RunningJoke/reactionButton/docs/firmware/architecture.md

# Firmware architecture

## 1. Hardware and quick facts

| Item | Value |
|---|---|
| MCU | ESP32-C3 (single-core RISC-V, 160 MHz), board `esp32-c3-devkitm-1`, 4 MB flash |
| Framework | PlatformIO, `framework = arduino, espidf` (Arduino as ESP-IDF component) |
| Button | GPIO 3, active LOW (external pull-up, `pinMode INPUT`); RTC pin, wakes from deep sleep |
| LEDs | 18 × WS2812 (GRB, 800 kHz) on GPIO 7 |
| Battery | GPIO 5, ADC2 (`analogReadMilliVolts`) through a 1:1 divider (2 × 100 k) |
| Random seed | GPIO 0 ADC read once |
| Pod link | ESP-NOW, WiFi channel 1, ≤ 7 peripherals (`CentralRole::MAX_PERIPHERALS`); shipped programs use ≤ 4 |
| Phone | BLE (NimBLE-Arduino 1.4.3 host on the IDF controller, ADR 0008), peripheral role, one phone, MTU 517; central only |
| Libraries | Adafruit NeoPixel ^1.12.0, ArduinoJson ^7.4.2, NimBLE-Arduino 1.4.3 |

Sources: `hardware/pcb` (KiCad), `hardware/casing` (FreeCAD).

## 2. Build configuration

| File | Purpose |
|---|---|
| `platformio.ini` | single env `NewBoard`, USB-CDC console |
| `sdkconfig.NewBoard` | WiFi + SW coexistence, BT controller only (`BT_CONTROLLER_ONLY`; the host stack is NimBLE-Arduino), `FREERTOS_HZ=1000`, task WDT off, C++ exceptions off, `-Os`, log level INFO (`CONFIG_LOG_MAXIMUM_LEVEL=3`), assertions on, `CONFIG_ADC_ONESHOT_FORCE_USE_ADC2_ON_C3`. Controller limits are changed here (`pio run -d firmware -t menuconfig`); NimBLE host limits are `-DCONFIG_BT_NIMBLE_*` build flags in `platformio.ini` |
| `partitions.csv` | nvs 20 KB, otadata, **two** app slots `ota_0` / `ota_1` 1 792 KB each, SPIFFS 384 KB, coredump 64 KB (ADR 0009) |
| `CMakeLists.txt`, `src/CMakeLists.txt` | ESP-IDF glue (globs `src/`) |

**Serial port:** with `arduino, espidf` the core is built without `ARDUINO_USB_CDC_ON_BOOT`, so `Serial` is
UART0 (GPIO 20/21). The firmware uses its own USB console (`Config/Console`), which also gets the ESP-IDF
log. Do not add `ARDUINO_USB_CDC_ON_BOOT`/`ARDUINO_USB_MODE` to `platformio.ini` (they only reach `src/`,
`Serial` would mean two objects). Panic dumps still go to UART0; the `boot` event (reset reason + last
step) replaces them.

## 3. Modules (`src/`)

```
main.cpp            setup(): battery gauge, role; loop(): battery, role
_Definitions.h      FW_VERSION_*, pins, ESP-NOW channel, BLE UUIDs, LED_BRIGHTNESS_CAP, AUTO_POWER_OFF_MINUTES
Roles/              RoleManager (role at boot), IRole (run, idle, powerOffAllowed)
  Central/          CentralRole (menu, discovery, confirm, run, pause), PodNetwork (claims, heartbeats,
                    ARM/RESET/EFFECT, events; implements Link/IPodNetwork), PhoneConfig (BLE config API)
  Peripheral/       PeripheralRole (announce, claim, clock sync, arm/measure/report, identity)
Link/               Protocol.h (wire format), EspNowLink (reliable ordered unicast, dedupe, tx timestamps,
                    idleWait), ClockSync.h, IPodNetwork.h, HoldSession (hold measuring + animation)
Config/             ConfigApi (JSON requests, shared by BLE and USB), SerialConsole, Console
Diagnostics/Diag    reset reason + last step across reboots
Settings/           NVS: set id, store generation, boot role, set name, PIN
Power/AutoPowerOff  idle timer, goodbye animation, deep sleep (§8)
Battery/            cell voltage, percent, low-battery thresholds
Store/              ProgramStore (files, CRC, manifest, atomic commit, generation), StoreSync (pod-to-pod)
BlockManager/       loads programs, runs the block graph (§6)
Block/              Block base (configure / enter / execute / exit / resume, named ports), BlockContext,
                    Value (constant or variable), JsonUtil, BlockFactory (type → class), EffectTarget,
                    Countdown, RandomUtil, one folder per block type
Program/ProgramCatalog  menu from /programs.json
Input/Button        debounced, edge counters, µs timestamps
Results/            Results (records, statistics, RESULT/SUMMARY lines), Reports (log + report buffer)
VariableManager/    int64 variables, names resolved to ids at load
LEDManager/         NeoPixel wrapper, effect player, SystemPattern (§7.1), Identity.h, EffectJson
ColorSet/           RGB + colour constants
```

Managers are lazily created singletons (`getManager()`), allocated once, never freed. Blocks use
`BlockContext`, not the singletons.

## 4. Boot

Power on → Serial, SPIFFS, pins → BOOT pattern 2.6 s (§7.1: battery gauge 1 s, then white fills the ring in
1.6 s) → button held at the end?
yes: `CentralRole` (BLE `ReactPod xxxx`), no: `PeripheralRole` (ESP-NOW, HELLO). The role changes only by
reboot. Wake from deep sleep is a normal boot.

### 4.1 First start after a firmware update (#124, ADR 0009)

`CONFIG_APP_ROLLBACK_ENABLE` is on, and `Ota.cpp` overrides the framework's weak `verifyRollbackLater()`, so
`initArduino()` does **not** mark the new image valid (its default does so unconditionally). The image stays
`ESP_OTA_IMG_PENDING_VERIFY`, and `Ota::service()` decides once, 15 s after start (`SELF_TEST_MS`):

- **Self-test passes:** `esp_ota_mark_app_valid_cancel_rollback`, `info.ota.lastResult` = `ok`. The test is
  deliberately small, so that no ordinary situation fails it: SPIFFS mounted, the role object exists, and the
  radio of the role is up: BLE (NimBLE initialised) on a central, ESP-NOW on a peripheral. The central's
  ESP-NOW radio is off in the menu (#122), so it is not tested there. Not tested: a phone, peripherals,
  programs, battery.
- **Self-test fails:** `esp_ota_mark_app_invalid_rollback_and_reboot` returns to the old slot at once. If there is
  no valid other slot (the call returns an error), the image is kept and marked valid: a pod never
  boot-loops. A pod flashed over USB is never on trial (the upload resets `otadata`, state undefined), so
  this does not apply to it.
- **Panic, watchdog or any reset inside the 15 s** (also a power cut): the bootloader sees `PENDING_VERIFY`
  at the next reset, marks the image aborted and starts the old one. A pod switched off in the first 15 s
  after an update therefore comes back with the old firmware; this is the design (the image has not
  proved itself yet), the update has to be repeated.
- **Role after a rollback.** `otaActivate` stores the pod's role in the high nibble of the pending-slot entry. The failed
  boot uses up the one-shot boot role, so after a rollback `Ota::boot` sets it again: a central that rolled back comes
  back as a central, not as a peripheral. An entry written by firmware 2.19 has no role (a rollback to or from it keeps the
  old behaviour).
- `otaBegin` is refused with `busy` during the 15 s (ESP-IDF cannot start a new image while the running one
  is pending).
- `lastResult` (`Ota::boot`): `otaActivate` stores the new slot in NVS. At the next start the pod compares
  it with the running slot: equal and valid: `ok`; equal and still pending: wait for the verdict; different:
  the bootloader rolled back, `rolledBack` if `esp_ota_get_last_invalid_partition` is that slot. The entry
  is cleared on that boot, the result stays until the next `otaBegin`. This NVS comparison is kept (instead of
  asking only `esp_ota_get_last_invalid_partition`) because it also knows `ok` and can be reset by `otaBegin`,
  while the invalid mark stays in `otadata` until the slot is written again.

### 4.2 Signed images (#134, ADR 0009)

`CONFIG_SECURE_SIGNED_APPS_NO_SECURE_BOOT` + `CONFIG_SECURE_SIGNED_APPS_RSA_SCHEME` +
`CONFIG_SECURE_SIGNED_ON_UPDATE_NO_SECURE_BOOT` (`sdkconfig.NewBoard`): `esp_ota_end` (and `esp_ota_set_boot_partition`)
verify an RSA-3072 signature block (secure boot v2 format, appended after the image, 4 KB aligned) in the app, **without**
secure boot: no eFuse is read or burned, `CONFIG_SECURE_BOOT` and flash encryption stay off, the bootloader does not
check signatures, USB flashing of any image still works. The trusted key is the one the **running** image was signed with
(`esp_secure_boot_get_signature_blocks_for_running_app`, nothing is embedded in the source): an update is accepted only
if it carries a valid block of the same public key. So a pod must itself run a signed image, and a pod flashed with a
developer build (test key) accepts only developer images. `firmware/sign_ota.py` (PlatformIO `post:` script) signs
`firmware.bin` after every build with `espsecure.py sign_data --version 2` and checks the result. Cost: `firmware.bin`
+13 KB (code 9 KB, signature sector 4 KB). Setup, release key and tests: testing §14, skill `/release`.

## 5. State machines

### 5.1 Peripheral

| State | Enter / behaviour |
|---|---|
| UNCLAIMED | SEARCH: amber spot bouncing over LEDs 8–17 (fw ≥ 2.15; 2.13–2.14: yellow + MAC-derived 2-LED segment); HELLO every 250 ms; hold the button 3 s → set id cleared (white flash 0.5 s) |
| READY | CLAIM from a central of its set (or any, if unpaired); PING every 200 ms; JOINED while the central sets the identify flag: n LEDs (pod n) flash twice, then 30 %; LEDs 8–17 breathe green. A re-claim flashes again (fw ≥ 2.15; 2.13–2.14: number, then spin; link-protocol §2.4) |
| READY, battery < 15 % | LOW_BATTERY replaces JOINED: LED 9 amber, 200 ms on per second (§7.1) |
| SCHEDULED | ARM with a start time; → ACTIVE when the synced clock reaches it |
| ACTIVE | LEDs updated, then `t0` taken; only presses that start after count; reaction = press edge − `t0` (µs) |
| DONE | press reported (PRESSED); → READY on RESET |
| HOLDING | CHARGE / RELEASE activation running (`HoldSession`) |
| UPDATE | firmware update from the central (fw ≥ 2.20, link-protocol §5.3): entered with `OTA_OFFER` from READY. The slot is erased (about 4 s, PING `otaState` preparing first, supervision restarted afterwards), then the image is pulled (`@ota`) or heard (`OTA_CHUNK`), chunks in any order (`OtaBitmap`), written with `esp_ota_write_with_offset`, hashed from the flash, `esp_ota_end`, READY ring green. PING/PONG go on, ARM / EFFECT / RESET are ignored. Left by `OTA_ACTIVATE` (restart as peripheral), by a PONG without `PONG_FLAG_OTA` (discard, READY), or by losing the central (UNCLAIMED). A failed update stays `failed` (red blink, then dark) until the central ends the distribution |

RESET from any armed state → READY. No PONG for 2 s → UNCLAIMED. Frames are handled on arrival, in send
order. An EFFECT takes the ring until it ends; ARM or RESET gives the ring back to the activation.

### 5.2 Central

| State | Enter / behaviour |
|---|---|
| MENU | menu from `/programs.json`, the program's own pattern shown at once (static); the boot hold is ignored until released; short press (< 1 s) = next program; hold: after 200 ms SELECT (white fills clockwise, full at 1.8 s = load it), released earlier: SELECT_CANCEL (§7.1); MaxLoop override read now, then the characteristic is reset to `-1` (it applies to this select only) |
| SELECTED | the ring flashes white twice (0.7 s), then DISCOVERY |
| ERROR | no programs or load error: red blink (1 s on/off), reboot needed. Programs can still be uploaded |
| DISCOVERY | non-blocking, one claim per HELLO; LEDs 0–7 pod markers in the pod colour, SEARCH on 8–17 (§7.1); SOLO (0 peripherals) never starts ESP-NOW |
| CONFIRM | all required pods claimed: READY (whole ring breathes green); a press that starts after entering starts the game; earlier events dropped. `setVariables` is accepted here (`startVars`, config-api §3): the values are used by the first cycle. Start refused below 5 % battery: red 1 s |
| RUN | the game. `stop` (config API) leaves any state after MENU for MENU without a reboot: block, variables, results and reports are dropped, the ring shows the menu, BLE stays connected, the radio keeps running and the joined pods get RESET and stay joined (UNCLAIMED only if the central is silent > 2 s). The next `select` keeps the first `peripherals` of them and goes through DISCOVERY |
| DISTRIBUTING | `otaDistribute` from MENU (fw ≥ 2.20, link-protocol §5.3): ESP-NOW on, pods claimed as in DISCOVERY, no game, no store sync, `PONG_FLAG_OTA` set. `PodNetwork::otaService` offers the image (one pod at a time, or all pods and a broadcast pass), ring: UPDATE bar with the mean progress, UPDATE_READY when every pod is ready. Left by `otaAbort` / `stop` (MENU) or `otaActivate` (OTA_ACTIVATE to the ready pods, then the central restarts as central) |
| PAUSED | PAUSED pattern (whole ring breathes amber) for a pod silent > 1.5 s or phone `pause` (`phonePaused`). Pod loss resumes by itself when all are back; a phone pause only with `resume` (config-api §5). The current block is left and re-entered (re-arms its pods) |

BLE (fw ≥ 2.12, `liveBle`, ADR 0005) stays connected in every state; `PhoneConfig::service()` runs in
`CentralRole::run()`, responses go out from a sender task (link-protocol §6). Lights with a start time
(`syncStartMs`) are armed on an esp_timer by `LEDManager::playEffect` (timing §4.1).

## 6. Block engine

### 6.1 Loading (`BlockManager::loadProgram`)

1. Clear blocks and variables. 2. Read the file; load `include`s first (recursive, depth ≤ 3), then its
`peripherals`, `variables`, `blocks`. 3. Per block `BlockFactory::create(type)` → `configure(json)`
(variable names → `VarId`). 4. Resolve port targets to indices. Unknown names, duplicates, unknown types
and bad parameters abort with a message naming file and block → error blink.

### 6.2 Execution (`BlockManager::run`, once per `loop()`, after `button.update()` and `network.service()`)

```
repeat up to 32 times:
    status = current.execute(ctx);  if running: return
    next = target[status.port];  if unconnected and block has "next": next = target[next]
    current.exit(); timerStop
    if no next: program ends
    current = next; timerStart; current.enter()
```

Semantics in detail: programs.md §7.

| JSON `type` | Class | Ports |
|---|---|---|
| `led` | `LEDBlock` | next |
| `delay` | `DelayBlock` | next |
| `button` | `ButtonBlock` | next, short, long, pressed, timeout |
| `if` | `IfBlock` | true, false |
| `setVariable` | `SetVariableBlock` | next |
| `remotePress` | `RemotePressBlock` | next, timeout |
| `remoteMultiPress` | `RemoteMultiplePressBlock` | next, avoidHit, timeout |
| `remoteResetAll` | `RemoteResetAllBlock` | next |
| `summary` | `SummaryBlock` | next |
| `repeat` | `RepeatBlock` | next, body, done |
| `effect` | `EffectBlock` | next |
| `charge` | `ChargeBlock` (on `HoldBlock`) | next, released, early, full, timeout |
| `release` | `ReleaseBlock` (on `HoldBlock`) | next, noHold, falseStart, timeout |
| `toggle` | `ToggleBlock` | next, allA, allB |
| `communicate` | `CommunicateBlock` | next, pressed, timeout, repeat, stop |

### 6.3 New block type

1. `src/Block/MyBlock/MyBlock.{h,cpp}` deriving from `Block`: `configure(json, ctx)` (use `Value`,
   `JsonUtil`; `ctx.fail("…")` on bad input), `enter(ctx)` (reset, take times), `execute(ctx)`
   (`BlockStatus::running()` / `done(port)`), `portCount()`/`portName(i)`, `onProgramStart()` for state
   across entries, `resume()` if a pause must not re-run `enter()`.
2. One line in `BlockFactory.cpp`. 3. Then the `/fw-api-change` skill (validator, program model, app).

### 6.4 System variables

| Variable | Set from | Used by |
|---|---|---|
| `REQUIRED_PERIPHERALS` | `peripherals` | CentralRole (pods to claim), programs; also the central's pod id |
| `NODE_COUNT` | `peripherals + 1` | programs |
| `MAX_LOOPS` | program variables; MaxLoop characteristic overrides it at selection | `lib/loop.json` |

Unknown variables read 0.

### 6.5 Events and measurements

- ESP-NOW receive callbacks (WiFi task) only queue frames; `PodNetwork::service()` turns them into
  `PodEvent`s in the loop: PRESSED `{podId, cmdSeq, result, reactionUs, rxTimeUs}` (+ `owner`, `flipCount`
  for TOGGLE), RELEASED `{flags, heldMs, chargeMs}`.
- `IPodNetwork::arm()` returns the `cmdSeq`; a remote block accepts only events with its pod and `cmdSeq`.
- `record` / `timerStop` → `Results`: `RESULT,…` line, per-metric statistics for `summary`, and the
  measurement log (48 values) that `communicate` turns into reports (8 in RAM until `ack`).

## 7. LEDs (`LEDManager`)

- Colour index on the wire: `0 red, 1 green, 2 blue, 3 yellow, 4 magenta, 5 cyan, 6 white, 7 orange, 8 violet,
  10 cream, 255 off`; 7, 8 and 10 are identity colours, pods only (10 from fw 2.15). 9 amber is local only
  (battery warning, system patterns), never sent by a central. Other values ignored.
- Static calls: `setLEDColors(ColorSet*)`, `(colorId)`, `(index, ColorSet*)`, `(LEDPattern*)` (≤ 8 palette
  colours, 3 bits × 18 in a `uint64_t`, optional animation), `setSegment(first, count, colorId, restId)`.
  Every static call stops a running effect.
- `playEffect(EffectDesc, startUs, ledMask)` (fw ≥ 2.8): one effect at a time, frames = f(time since
  start) (link-protocol §2.1), shown only when changed, ≤ every 16 ms; first frame inside `playEffect`
  or from an esp_timer at a future start. `service()` runs after the role every pass and returns at once
  when nothing animates.
- Every driver write goes through `present()`: `show()` only if the buffer differs (fw ≥ 2.14).
- `setBrightnessCap(0…255)` scales all output; default `LED_BRIGHTNESS_CAP` 255.
- Other pods: `IPodNetwork::effect(pod, desc, startAtUs)`, `ArmCommand::waiting`; check
  `supportsEffects(pod)`, older pods get static colours. `Block/EffectTarget` and `Block/Countdown` build
  `EffectDesc`s from block fields; `LEDManager/EffectJson` parses the `effect` test op.
- `playPattern(SystemPattern::Id, Args, startUs)` (fw ≥ 2.15, #82): plays a system pattern (§7.1) on the same
  effect player. A pattern is a pure function of the time since its start, like an effect. The ring as it is
  when a pattern starts is the snapshot that SELECT / SELECT_CANCEL draw over. A pattern ends an effect and
  the other way round; every static call stops both. `currentPattern()` gives the last one. Patterns are
  firmware only: not on the link, not in programs. Levels are perceived brightness (gamma 2), shown at 50 % of the game brightness (`SYSTEM_LEVEL`): close range only; games stay at full brightness.
- Identity (fw ≥ 2.13): palette in `LEDManager/Identity.h` (fw ≥ 2.15: blue, cyan, violet, magenta, yellow,
  orange, cream), drawn by `PeripheralRole::updateIdentity` (fw ≥ 2.15: JOINED pattern, n LEDs); the
  central's own `blink` is white (`CentralRole::opBlink`); the menu flag goes out through
  `PodNetwork::setIdentify`.

### 7.1 Light language (fw ≥ 2.15, #82)

Pattern names as in `SystemPattern.h` (test op `pattern`, config-api §5). Timings in ms. Levels are
perceived brightness (gamma 2). `Snapshot` = the ring as it was when the pattern started. Light lab values
for orange, violet and cream are provisional until checked on the real LEDs (bright hall, 1 m and 10 m).

| State | Pattern | Colour | Timing |
|---|---|---|---|
| Power-on (every pod) | BOOT | battery gauge blue-cyan (0, 70, 255) at 60 % ( amber below 20 %; full without a reading), then white | gauge fills with ease-out in 500, holds to 1000; white fills the ring over 1600 (timer). Total 2600. Button held at the end → central, else peripheral. Wake from deep sleep too |
| Peripheral unclaimed | SEARCH | amber spot with a 3-LED tail over LEDs 8–17 | 2000 per way, reverses at the ends; not synced |
| Peripheral: hold 3 s | (white flash) | white, whole ring | 500; pairing cleared |
| Peripheral claimed, central in MENU / DISCOVERY / CONFIRM (identify flag) | JOINED | own colour on LEDs 0 … n−1 (pod n): two flashes, then 30 %. LEDs 8–17 green | flash 225 each; green breathes 2200 (floor 15 %). Flag cleared: dark. A re-claim flashes again |
| Peripheral claimed, battery < 15 %, idle | LOW_BATTERY | amber, LED 9 only (replaces JOINED) | 200 on per 1000; 5 % between |
| Central MENU | MENU | the program's menu pattern (snapshot) | static; breathes 2200 (floor 15 %) while a phone is connected |
| Central MENU, button held | SELECT | white fills clockwise over the snapshot | starts after 200; fill 1600 (full at 1800 = selected) |
| Central MENU, button let go early | SELECT_CANCEL | white drains back to the snapshot | same speed as the fill |
| Program selected | SELECTED | whole ring white | two flashes, 150 on / 150 off; 700, then discovery |
| Central DISCOVERY | DISCOVERY | LEDs 0–7: pod i+1 marker in its colour at 25 %, full once claimed; SEARCH on 8–17 | – |
| Central CONFIRM (all pods here) | READY | whole ring green | breathes 2200 (floor 15 %) |
| Start refused (pod < 5 %) | – | red, whole ring | 1000, then READY again |
| Central PAUSED | PAUSED | whole ring amber | breathes 2600 (floor 15 %) |
| Central ERROR | – | red | blink 1000 on / 1000 off (unchanged) |
| Firmware update (#125, #123: `otaBegin` ... `otaEnd`) | UPDATE | dim white bar (40 %) fills clockwise, one LED per 5.6 % (`updateProgress`, ≤ 20 fps, drawn between a request and its response: a frame sent while bytes arrive flickers); the rest breathe dark red | breathes 2200 (floor 30 %, peak 60 % of dark red); the colours are a first guess, check on the LEDs |
| Firmware update, image being checked (#125; not played by `otaEnd`, which takes about 150 ms and keeps the bar) | UPDATE_VERIFY | full white bar, dimmed, breathing | breathes 2200 at 60 % |
| Firmware update, waiting for the other pods (#125) | UPDATE_READY | whole ring green | static, 30 % |
| Distribution (#130): central, and a peripheral receiving from the central | UPDATE | as above; the central shows the mean of the pods, a peripheral its own chunks | as above |
| Firmware update failed (#125) | UPDATE_FAILED | red, whole ring (the error blink) | blink 1000 on / 1000 off, three times (6000), then dark; the normal state again |
| Auto power-off | SLEEP | white ring drains anticlockwise with ease-out while dimming to dark | drain 1600, dim 2000, then deep sleep (§8.2) |
| Game | – | owned by the program (effects, colours) | unchanged |

Breathing: raised cosine between the floor and full; it starts at the floor, so dark never means breathing.
Colours: cyan, green, amber, red, white from `ColorSet`; the pod colour from `Identity::colorOf` (§7).

## 8. Power (fw ≥ 2.14, #21)

### 8.1 Idle loop
In idle states (peripheral UNCLAIMED / READY, central MENU / CONFIRM / ERROR) the loop waits ≤ 1 ms for a
radio frame (`IRole::idle()`, `EspNowLink::idleWait`; a frame wakes it at once). Armed activations and
games never wait (timing §1).

### 8.2 Auto power-off
`AutoPowerOff::service(IRole::powerOffAllowed())` every pass. Allowed: peripheral UNCLAIMED; central MENU
without a phone (`PhoneConfig::connected()`). Not allowed: any claimed peripheral, central with a phone or
in DISCOVERY / CONFIRM / RUN / PAUSED / ERROR. A press (or held button) and a USB host
(`HWCDC::isPlugged()`; a plain charger is no host) restart the idle time. `status.powerOff {idleMs,
limitMs, usbHost}` counts `idleMs` as if no host were connected. After `AUTO_POWER_OFF_MINUTES` (10): SLEEP
pattern (§7.1: white drains anticlockwise with ease-out in 1.6 s while dimming to dark over 2 s), `sleep`
event, deep sleep with GPIO 3 LOW wake-up → normal boot (BOOT pattern).

Limits: the WS2812s keep drawing ≈ 0.5–1 mA each unless their supply is switched (check the schematic
for an LED power switch); the power switch cuts everything. A sleeping pod cannot answer HELLO: press
each waiting pod before the discovery.

### 8.3 Light sleep: not used
ESP-NOW must keep receiving; a claimed pod always listens for ARM / EFFECT.
