RunningJoke/reactionButton/docs/firmware/config-api.md

# Configuration API (BLE and USB serial)

Same JSON messages on both transports. Reference clients: `tools/reactpod_config.py` (BLE, `bleak`),
`tools/reactpod_serial.py` (USB, `pyserial`, see testing.md). Implementation: `Config/ConfigApi`.

| Transport | Where | When |
|---|---|---|
| BLE | central | menu; from fw 2.12 (`liveBle`) also during the game |
| USB serial | any pod | always |

## 1. Availability over BLE

- Central = button held when the boot pattern ends (architecture §4, §7.1). Advertises `ReactPod <xxxx>` (§2.1). An empty central (no
  programs) stays in the menu with the red blink, so programs can be uploaded.
- fw ≥ 2.12 (`liveBle`): the connection stays through DISCOVERY, CONFIRM, RUN, PAUSED (interval and
  advertising: link-protocol §6). From DISCOVERY on `put`, `delete`, `setName` answer `busy`; everything
  else works, including reports, `command`, `setVariables`, `session`.
- fw < 2.12: BLE goes off at program select (the connection drops); API in the menu only.
- After `put` / `delete` the menu reloads at once; the set syncs the store automatically (§6).

## 2. GATT

Service `12345678-1234-1234-1234-1234567890ab`.

| Characteristic | UUID suffix | Props | Use |
|---|---|---|---|
| Command | `…90b1` | Write, Write w/o response | requests |
| Response | `…90b2` | **Indicate only** (CCCD) | responses + `report` events |
| MaxLoop | `…90a7` | Write, Read | ASCII number > 0 overrides `MAX_LOOPS` of the next selected program only; then the characteristic is reset to `-1` (none) |

Subscribe for indications (Web Bluetooth `startNotifications()`, Android / bleak `start_notify()` pick them).
Confirmations are the flow control (fw 2.0 also offered notify, which made responses get lost). The pod
requests MTU 517; the API works with 23, just slower.

### 2.1 Advertisement
Advertisement: flags, 128-bit service UUID, manufacturer data `0xFFFF` + `setId` (4 bytes BE). Scan
response: name, preferred connection interval. Name: `ReactPod <last 4 hex of setId>` or `ReactPod <set
name>` (≤ 25 bytes); filter with the service UUID + `namePrefix: "ReactPod"`. The set name is stored on
the central only (not synced) and advertised after the current connection ends.

## 3. Framing

- One JSON object + `\n` per message (UTF-8, no newline inside). May be split over any number of writes /
  indications; ≤ *MTU − 3* bytes per BLE write.
- **One request at a time**: wait for the response. Max request 12288 bytes (`maxRequest`).
- Optional `"id"` (any JSON) is echoed with `"op"`.
- Success `{"op","id","ok":true,…}`, error `{"op","id","ok":false,"error":"<code>","message":"…"}`.

| Error | Meaning |
|---|---|
| `bad_request` | not JSON, unknown op, missing / bad field (also an unknown pod id) |
| `bad_path` | path not allowed (§4) |
| `not_found` | file missing |
| `bad_offset` | `get` past the end / `put` or `otaWrite` not continuing the upload (`otaWrite` also returns `received`) |
| `too_large` | file > 16384 or request > 12288 bytes; `otaBegin` image larger than the slot, `otaWrite` past `size` |
| `crc_mismatch`, `invalid_json` | final `put` chunk rejected, nothing stored |
| `invalid_program` | `validate`: `message` names file + block |
| `storage` | flash write failed (`otaBegin` / `otaWrite`: the update is `failed`) |
| `ota_failed` | firmware update (§5 Firmware update): image or hash rejected, nothing activated (fw ≥ 2.19) |
| `overflow` | data came faster than processed: resend |
| `auth_required`, `auth_failed` | PIN (§8) |
| `busy` | not now: file change from DISCOVERY on, validate during a game, sync, effect / pattern while armed; `select` while an update runs; `otaBegin` outside the menu or while the new image is on trial (15 s after an `otaActivate`) |
| `not_ready` | no block waits / pods missing / pod too old; `otaWrite` / `otaEnd` / `otaActivate` in the wrong update state; `otaDistribute` without a verified image; `otaActivate` of a set with pods that are not ready (the error carries `pods`: their ids) |
| `low_battery` | `start` with a pod < 5 % (fw ≥ 2.13); `otaBegin` below 30 % (fw ≥ 2.19) |
| `not_editable`, `out_of_range` | `setVariables` |
| `not_running`, `not_paused` | `pause` outside RUN, `resume` without a phone pause |

## 4. Files

| Path | Content |
|---|---|
| `/programs.json` | menu `{"programs": ["/prog/solo.json", …]}` in order |
| `/prog/<name>` | programs and include fragments (`/prog/lib/loop.json`) |

Paths ≤ 31 characters incl. leading `/` (SPIFFS); after `/prog/` only `A–Z a–z 0–9 _ - . /`, no `..`,
`//` or trailing `/`. Valid JSON (format: programs.md), ≤ 16384 bytes. **Offsets and sizes are UTF-8
bytes.** CRC = standard CRC-32 (zlib), 8 hex digits.

## 5. Operations

### Feature detection (`info`)

```json
→ {"op":"info"}
← {"op":"info","ok":true,"firmware":"2.14","linkProtocol":1,"linkRevision":4,"setId":"5f3a91c2","setName":"",
   "pinRequired":false,"generation":7,"storeHash":"0a1b2c3d","freeBytes":1801234,"maxFileSize":16384,
   "maxPathLength":31,"maxRequest":12288,"maxGetChunk":4096,"mtu":247,"programFormat":6,
   "features":["validateInline","listMeta","effects","hold","toggle","reports","remote","liveBle","pause","identify","battery"],
   "blockTypes":["led","delay","button","if","setVariable","remotePress","remoteMultiPress","remoteResetAll",
                 "summary","repeat","effect","charge","release","toggle","communicate"]}
```

A missing field means the old behaviour. `linkProtocol` = frame header version (always 1);
`linkRevision` (missing = 1), link-protocol §7. `programFormat` (missing = 1) = programs.md §6; check it
before uploading programs that use newer blocks or fields. `mtu` (BLE only): write ≤ `mtu − 3` (Web
Bluetooth does not expose it). `features` and fields by firmware:

| fw | Field / feature | Meaning |
|---|---|---|
| 2.2 | `setName` | stored set name (`""` = none), op `setName` |
| 2.3 | `programFormat` | |
| 2.4 | `validateInline` | `validate` accepts `data` (dry run) |
| 2.5 | `listMeta` | `list` reports program metadata |
| 2.6 | `pinRequired` | a PIN is set and this transport (BLE) needs it |
| 2.7 | `mtu` | negotiated ATT MTU (23 until exchanged) |
| 2.8 | `effects` | effect player, op `effect`, `status.pods[].effects` |
| 2.9 | `hold`, `linkRevision` | firmware speaks link revision 2; per pod: `status.pods[].hold`. Block types `effect`, `charge`, `release` and `countdown` need `programFormat` ≥ 3 (and the effect player) |
| 2.10 | `toggle` | block `toggle` (`programFormat` ≥ 4), link revision 3; per pod `status.pods[].toggle` |
| 2.11 | `reports`, `remote` | report buffer, `report` event, ops `reports`/`ack`; ops `command`/`setVariables`/`session`; block `communicate` (`programFormat` ≥ 5) |
| 2.12 | `liveBle`, `pause` | BLE stays in the game (§1), `report` over BLE, `status.ble`, `status.heap`, `reports` paging; ops `pause`/`resume`, `phonePaused` |
| 2.13 | `identify`, `battery` | op `blink`, `pods[].number`/`color`; `status.battery`, `pods[].battery`, `low_battery`; `programFormat` 6 |
| 2.14 | – | `status.powerOff`, `sleep` event |
| 2.15 | `patterns` | op `pattern`; system patterns (architecture §7.1); link revision 5 (colour 10, identity as n LEDs in the new palette) |
| 2.17 | `startVars` | `setVariables` also in CONFIRM; `status.ready.editable` (§3 start variables); MaxLoop override cleared after the next select |
| 2.18 | – | `stop` returns to MENU without a reboot (BLE stays connected, peripherals stay joined) |
| 2.19 | `ota` | firmware update over the config API (ops `otaBegin`, `otaWrite`, `otaEnd`, `otaActivate`, `otaAbort`), `info.ota`, `status.ota`; USB requests up to `maxRequest` (12288) work (before: about 4 KB) |
| 2.20 | `otaDistribute` | central only: op `otaDistribute`, `status.ota.pods[]`, `status.pods[].firmware`, `otaActivate` for a whole set, `otaBegin.linkProtocol`; link revision 6 (link-protocol §5.3) |

**Battery** (`{percent, mv}`, missing = unknown): one Li-ion cell, 3.30 V = 0 %, 4.20 V = 100 %, piecewise
linear (`Battery.cpp`); 16 samples, refreshed every 3 s; on USB it reads the charge voltage (≈ 100 %).
Below 15 % an idle pod blinks amber; below 5 % `start` is refused (`low_battery`, the confirm press flashes
the ring red 1 s).

### `list`
```json
← {"op":"list","ok":true,"generation":7,"storeHash":"0a1b2c3d",
   "files":[{"path":"/programs.json","size":231,"crc":"8c1d0e2f"},
            {"path":"/prog/duo.json","size":1450,"crc":"1f2e3d4c","name":"Duo","peripherals":1,"menu":[{"leds":[8,10],"color":"blue"}]},
            {"path":"/prog/lib/loop.json","size":610,"crc":"5a4b3c2d","fragment":true}],
   "menu":["/prog/solo.json", …]}
```
With `listMeta`: a `/prog/` file with a string `name` is a program (`name`, and `peripherals` / `menu` as in
the file if present); a JSON object without `name` is `"fragment": true`; others get neither. Cached by
path + CRC.

### `get` (chunked)
`{"op":"get","path":…,"offset":0,"length":2048}` → `{…,"offset","size","crc","eof","data"}`. `length`
default 2048, max 4096 bytes. A chunk never splits a UTF-8 character (may be shorter); continue at
`offset + byteLength(data)` until `eof`. `crc` is of the whole file.

### `put` (chunked, atomic)
```json
→ {"op":"put","path":"/prog/my.json","offset":0,"data":"…","final":false}   ← {…,"received":2048}
→ {"op":"put","path":"/prog/my.json","offset":2048,"data":"…","final":true,"crc":"7a6b5c4d"}
← {"op":"put","ok":true,"path":"/prog/my.json","size":3012,"crc":"7a6b5c4d","generation":8}
```
`offset` 0 starts a new upload (discards an unfinished one); further chunks continue at `received`.
`final` defaults to true (small file = one request). The final chunk checks the optional `crc` and JSON
syntax, then replaces the old file atomically. Split between characters, count offsets in bytes. A
program is not in the menu until `/programs.json` is `put`: upload programs and includes first, the menu last.

### `delete`
`{"op":"delete","path":…}` → `{…,"generation":9}`.

### `validate`
`{"op":"validate","path":…}` → `{"ok":true,"blocks":14}` or `invalid_program` ("/prog/x.json: block 'Hit'
has unknown type 'buton'"). Loads with all includes, as the game would, without starting. With `data`
(`validateInline`): dry run of that text; `path` must be valid but need not exist, includes come from the
store (upload changed includes first), nothing is written, the request must fit `maxRequest`.

### Firmware update (`ota`, fw 2.19)

Replaces the firmware without USB: the image goes into the inactive one of two app slots (ADR 0009), is
checked, and the pod boots it on `otaActivate`. The programs and settings (NVS, SPIFFS) are not touched. The
old firmware stays in its slot; the image is only used after a successful `otaEnd` and `otaActivate`.

```json
→ {"op":"otaBegin","size":1095344,"sha256":"<64 hex>","version":"2.20","linkProtocol":1}
← {"op":"otaBegin","ok":true,"slotSize":1835008,"maxChunk":3072,"received":0}
→ {"op":"otaWrite","offset":0,"data":"<base64 of up to maxChunk bytes>"}
← {"op":"otaWrite","ok":true,"received":3072}
→ {"op":"otaEnd"}        ← {"op":"otaEnd","ok":true}       (SHA-256 and the image checked)
→ {"op":"otaActivate"}   ← {"op":"otaActivate","ok":true}  (then the pod restarts into the new firmware)
→ {"op":"otaAbort"}      ← {"op":"otaAbort","ok":true}     (any time; state back to idle)
```

- `otaBegin`: `size` (bytes of `firmware.bin`, > 0), `sha256` (hex of the whole image), optional `version`
  (≤ 31 characters, shown in `status.ota`; a central skips the pods that run this version), optional `linkProtocol`
  (1 … 255, the new firmware's link protocol: `otaActivate {"force":true}` needs it, fw >= 2.20). Answers at once, there is no long erase: each 4 KB sector is
  erased just before it is written (`OTA_WITH_SEQUENTIAL_WRITES`; the pod is busy for that time, the client
  sends one request at a time, so an `otaWrite` answers after about 80 ms instead of 30 ms). That mode needs
  the lossless, in-order stream that `bad_offset` enforces; it must not be used for a broadcast. The firmware
  can erase the whole slot in `otaBegin` instead (one constant in `Ota.cpp`): that answer then takes 4.4 s,
  and the pod does not serve other requests (BLE included) meanwhile.
- **Resume:** `otaBegin` with the same `size` and `sha256` while the update is `receiving` (the pod has not
  rebooted, nothing aborted it) continues it: `received` > 0 says where to go on. A dropped BLE or USB
  connection does not end the update. A different `size` or `sha256` discards the old one and starts anew.
  An update with no `otaWrite` for 10 minutes is discarded.
- `otaWrite`: `offset` must equal `received` (`bad_offset`, the error also carries `received`). `data` is
  base64 of 1 to `maxChunk` raw bytes (a request fits `maxRequest`). The first chunk must start with the
  image header, else `ota_failed`. Past `size`: `too_large`.
- `otaEnd`: needs `received` = `size` (else `not_ready`). Compares SHA-256 with `sha256` and lets the
  ESP-IDF check the image; failure `ota_failed`, the update is `failed`, nothing changes in the boot choice.
  Takes about 150 ms.
- `otaActivate`: only in state `ready`. Selects the new slot, keeps the current role for the next start
  (a central comes back as central) and restarts, like `reboot`. The new image is **on trial** (fw >= 2.19,
  architecture §4.1): it is marked valid only after 15 s and a self-test, otherwise the bootloader returns
  to the old firmware at the next reset. `info.ota.lastResult` reports the outcome.
- `otaAbort`: discards the update (also `ready` and `failed`).
- Rules: allowed only when the pod is in the **menu** (central: state MENU) or, for a peripheral, **not in a
  game** (unclaimed or ready), else `busy`. PIN as for `put` (`auth_required`, serial needs none), for all five
  ops. `otaBegin` below 30 % battery: `low_battery` (a pod with no reading is allowed). `size` above
  `slotSize`: `too_large`. `size` or `sha256` missing / bad: `bad_request`. During an update the pod does not
  switch off, `select` (and the menu button) is refused (`busy`), a peripheral ignores the central, and an
  unfinished update is lost on reboot. A write error in the slot is `storage`. `otaBegin` in the first 15 s
  after an `otaActivate` (the image is still on trial, the ESP-IDF refuses to write the next image then):
  `busy`, "the running firmware is still being tested"; try again after a few seconds.
- Ring (architecture §7.1): `UPDATE` with the bar while receiving and in `otaEnd`,
  `UPDATE_READY` once verified, `UPDATE_FAILED` (three red blinks) on failure; after `otaAbort`, a failure
  and the timeout the normal state of the role again.
- `maxChunk` is 3072 (4096 base64 characters). Over USB, measured with fw 2.19: 1.1 MB in 30 s (37 kB/s),
  the same at 2048 and at `maxChunk`; with the full-size erase 17 s (4.4 s `otaBegin`, then 84 to 86 kB/s).
- **Update of a whole set (central, fw >= 2.20, `info.features` `otaDistribute`).** After `otaEnd` the central hands
  the image to its peripherals over ESP-NOW while it keeps running the old firmware (link-protocol §5.3):
  - `{"op":"otaDistribute","mode":"auto|unicast|broadcast"}` (valid from MENU with a verified image, else `busy` /
    `not_ready`; default `auto` = broadcast when two or more pods need the image). Answers at once and works in the
    background. State `DISTRIBUTING`: ESP-NOW on, pods are claimed as in DISCOVERY, no game, no program store sync, no
    phone needed. `status.ota.state` stays `ready`.
  - `status.ota.pods[]` = `{id, state, percent, firmware}` from `otaDistribute` until `otaActivate` or `otaAbort`.
    `state`: `queued` (waits for its turn or the offer), `transferring` (erasing its slot, then receiving), `ready`
    (complete and verified), `current` (already runs the offered version, nothing sent), `failed` (hash / image
    rejected, storage error, pod without the `ota` link feature), `offline` (silent for 1.5 s), `refused` (battery
    below 30 %). `percent` 0 … 100. `status.pods[].firmware` = `"2.19"` as the pod announced itself (missing until it
    has joined).
  - `otaActivate` on a distributing central: sends `OTA_ACTIVATE` to every `ready` pod, then restarts the central
    (it comes back as central; the pods rejoin by the normal claim, the next `select` shows `status.pods[].firmware`).
    Pods that are neither `ready` nor `current`: error `not_ready` with `pods: [ids]`, nothing happens.
    `{"force":true}` activates the ready ones and leaves the others on the old firmware (listed, not hidden); it needs
    the new firmware's `linkProtocol` (from `otaBegin`) to equal the running one, else `bad_request`. The central
    never activates by itself.
  - `otaAbort` ends the distribution: the pods discard their update and are ready again, the central goes back to MENU
    and discards the central's own image as well (one update for the whole set). `stop` ends the
    distribution only (the image stays verified, `otaDistribute` can start again). A pod that fails stays `failed` until the distribution is aborted; a pod that reboots or is
    switched off meanwhile is offered the image again when it joins.
  - Ring: central `UPDATE` bar with the mean progress of the pods, `UPDATE_READY` when all are ready; peripheral
    its own bar (architecture §7.1).
- `status.ota` = `{"state":"idle|receiving|verifying|ready|failed","received":0,"total":0,"version":""}`
  (`verifying` is only visible to other transports, `otaEnd` answers when it is over).
  `info.ota` = `{"slotSize":1835008,"running":"app0","lastResult":"none|ok|rolledBack"}`: `running` is the
  slot of the running image; `lastResult` is the outcome of the last `otaActivate` (`none`: no update since the
  last `otaBegin`, or the new image is still on trial; `ok`: the new image runs and is valid; `rolledBack`: the
  new image panicked, failed its self-test or was reset inside the 15 s, and the bootloader returned to the old
  one). It is set at the start after the outcome and kept until the next `otaBegin`.

### Control and test ops

| op | Where | Request | Response / effect |
|---|---|---|---|
| `help` | any | – | list of ops |
| `status` | any | – | `role`, `state`, `firmware`, `uptimeMs`, `setId`, `mtu` (BLE), `store`, `heap {free, minFree}`, `powerOff {idleMs, limitMs, usbHost}`, `battery`, `lastReset {reason, lastStep}`. Central: `program`, `requiredPeripherals`, `radio`, `syncing`, `ble {connected, intervalMs}`, `pods[] {id, mac, alive, lastSeenMs, effects, hold, toggle, number, color, battery, link {txFrames, txRetries, txLost, rxFrames, rxDuplicates, ackUsLast, ackUsAvg, ackUsMax}}`, `block`, `timers {orphanStops}` (RUN/PAUSED, programs.md §7.9), `variables`, `athlete`, `reports {pending, dropped}`, `waiting {block, editable {<name>: {min, max, value}}}` (while a `communicate` block waits), `ready {editable {<name>: {min, max, value}}}` (CONFIRM only, §3 start variables), `phonePaused`. Peripheral: `podId`, `central`, `lastPongMs`, `clock {synced, offsetUs}`, `link` |
| `programs` | central | – | `programs[] {index, name, path, peripherals}`, `selected` |
| `select` | central, MENU | `program`: index, path or name | load, radio on, DISCOVERY |
| `start` | central, CONFIRM | – | like the confirm press; `not_ready` while pods are missing; `low_battery` |
| `press` | any | – | simulated short press (not for the menu) |
| `stop` | central | – | ends the program and returns to MENU in place, without a reboot: BLE stays connected, the joined peripherals get RESET and stay joined (the next `select` finds them at once). Clears reports, variables, results and the athlete; response `{ok, state:"MENU"}` (fw < 2.18: the pod restarts as central into the menu) |
| `effect` | any (`effects`) | `effect` name, `color`, `color2`, `brightness`, `durationMs`, `periodMs`, `segment`, `from`/`to` (dim), `value` (level %), `reverse`, `endOff`, `delayMs`; central also `target`: `"self"` (default), pod id, `"pods"`, `"all"` | test op; common start now + `delayMs` (default 50 ms with pods, else 0). → `effect`, central `startAtUs`, `sent[]`, `skipped[]`. `busy` in a game / while armed |
| `pattern` | any (`patterns`) | `name`: `boot`, `search`, `joined`, `discovery`, `ready`, `select`, `selectCancel`, `selected`, `paused`, `lowBattery`, `sleep`, `menu`, `update`, `updateVerify`, `updateReady`, `updateFailed`; `percent` (boot, 0–100; update, 0–100, the bar: 0, 50 and 100 preview it), `podId` (joined), `wanted`, `found` (discovery), `fillMs` (selectCancel), `breathing` (menu) | plays a system pattern (architecture §7.1) on this pod's ring; central: itself only, peripheral: itself. → `pattern`, `durationMs` (0 = endless; `updateFailed` 6000). `busy` in a game / while armed |
| `blink` | central (`identify`) | `pod`: id, or `-1`/missing = central | 2 s in its identity colour (central white), shown within 0.5 s. Only MENU/DISCOVERY/CONFIRM (`busy`); unknown id `bad_request`; pod fw < 2.8 `not_ready`. → `pod`, `durationMs` 2000 |
| `results` | any | `reset` (bool) | statistics per metric since the last summary |
| `trace` | any, serial | `on` (bool) | `{"event":"block","name","t"}` on every block entry |
| `reboot` | any | `role`: `central`/`peripheral`/`auto` | role for the next start only |
| `auth` | any | `pin` | unlocks writes for this BLE connection (§8); `ok` without a PIN |
| `setPin` | any, **serial only** | `pin`: 4–6 digits, `""` clears | → `pinSet` |
| `setName` | any | `name` ≤ 16 bytes UTF-8, no control chars, `""` clears | NVS, advertised (§2.1); `busy` from DISCOVERY |
| `reports` | central (`reports`) | `from`, `max` (paging, fw ≥ 2.12) | unacknowledged reports, oldest first (fields of the `report` event), `total`, `more`. A full buffer ≈ 20 KB: over BLE use `{"max":2}`, `ack`, repeat while `more` |
| `ack` | central | `reportId` | removes it and all older; unknown ids are fine (`id` is the request id) |
| `command` | central (`remote`) | `name`: `continue`/`repeat`/`stop` | answers a waiting `communicate` block; else `not_ready` |
| `setVariables` | central (`remote`) | `values {name: int}` | in CONFIRM (`startVars`) or while `communicate` waits; only names `editable` in the loaded program's `communicate` blocks (see start variables below); within min…max; errors `bad_request`, `not_editable`, `out_of_range`; all or nothing → `variables`. In CONFIRM the values are used by the first cycle. MENU / DISCOVERY → `not_ready` |
| `session` | central (`remote`) | `athlete` ≤ 40 bytes, `""` clears | opaque id copied into following reports (RAM). MENU/DISCOVERY/CONFIRM or while `communicate` waits, else `busy` |
| `pause` | central (`pause`) | – | RUN → PAUSED with `phonePaused`, current block left; else `not_running` |
| `resume` | central (`pause`) | – | re-enters the block (a `communicate` block keeps its report) → `state` RUN, or PAUSED while a pod is missing; without a phone pause `not_paused` |

### Start variables (`startVars`, fw 2.17)

In CONFIRM (READY) the app sets the program's variables, then starts. Allowed names: the union of `editable`
of all `communicate` blocks of the loaded program (incl. includes); a name in several blocks uses the narrowest
range (largest `min`, smallest `max`). `status.ready.editable` lists the same names with that range and the
current `value` (after a MaxLoop override); absent outside CONFIRM. Without `startVars` (fw < 2.17): `setVariables`
in CONFIRM → `not_ready`, no `ready` field.

```json
{ "op": "status" }
// CONFIRM → { ..., "state": "CONFIRM", "ready": { "editable": { "MAX_LOOPS": { "min": 1, "max": 50, "value": 12 } } } }
{ "op": "setVariables", "values": { "MAX_LOOPS": 20 } }   // in CONFIRM → { "variables": { "MAX_LOOPS": 20 } }
{ "op": "start" }                                            // first cycle runs with MAX_LOOPS 20
```

**Reports** are RAM only: `stop` and every reboot clear them, ids restart at 1.

**Two kinds of PAUSED** (both whole ring amber, both leave and re-enter the current block: timeouts restart,
presses during PAUSED are dropped, `communicate` builds no second report; `command` / `setVariables` /
`session` behave as in PAUSED: `not_ready` / `busy`):
- pod lost (automatic, 1.5 s silence): continues by itself when all pods are back. `pause` is refused
  (`not_running`) until then.
- phone pause (`phonePaused: true`): only `resume` ends it. A pod lost meanwhile changes nothing; `resume`
  with a pod still missing gives PAUSED with `phonePaused: false` (pod-loss rule).

### Events (serial; `report` also over BLE from fw 2.12)

| Event | Fields |
|---|---|
| `boot` | `role`, `firmware`, `lastReset {reason, lastStep}`; `panic`/`*watchdog`/`brownout` = crash, `lastStep` says where |
| `state` | `state`, `program`, `pods`, `required`, `phonePaused`: every central state change |
| `sleep` | `idleMinutes`: auto power-off (architecture §8.2) |
| `block` | `name`, `t`: only with `trace on` |
| `report` | `id`, `program`, `setId`, `athlete` (if set), `cycle`, `startMs`, `endMs`, `values[] {t, metric, pod, ms}`, `stats {<metric>: {count, average, best, worst}}`, `vars {<name>: value}`, `valuesDropped` (if > 0); programs.md §7.16 |

Text lines: `RESULT,<millis>,<metric>,<pod>,<ms>`, `SUMMARY,<metric>,<count>,<avg>,<best>,<worst>`.
Firmware log lines never start with `{`.

### Serial specifics
115200 baud (ignored by USB); lines end with `\n` or `\r\n`. Text shortcuts: `status`, `select 8`,
`select /prog/duo.json`, `get /prog/solo.json`, `reboot central`, `trace on`, `setPin 1234`,
`setName Halle 2`. Opening the port does not reset the pod. **Never toggle DTR/RTS** (resets the C3,
possibly into download mode).

## 6. Store sync between pods

Every pod keeps the full store; every API change raises the generation; pods compare generation + hash
in PING/PONG and the older one pulls the changed files, CRC-checked and switched together (details:
link-protocol §5.2). Not during RUN. A local change always wins over stores seen before. **Limitation:**
two pods edited separately → only one store survives; edit one pod, let the set sync (start any program
with all pods on), then edit again.

## 7. Typical upload

```
connect "ReactPod <xxxx>", subscribe to Response (indications), request MTU 517
info                          → firmware, programFormat, blockTypes, features
auth (if pinRequired)
put each program + include    (≤ 2048-character chunks, crc on the final chunk)
put /programs.json            (last)
validate each menu program    → show errors
```
Then start any program once with all pods on to spread the store (≈ 0.5 s per pod, estimate).

## 8. Security

No BLE pairing; without a PIN anyone in range can change programs. Optional PIN (fw ≥ 2.6):
- Set / clear over USB only (`setPin`), stored per pod in NVS (not synced: set it on every pod that may be
  central). A lost PIN is cleared with a cable.
- With a PIN, `put`, `delete`, `setName` over BLE return `auth_required` until `auth` on the same
  connection. After a wrong PIN `auth` is refused for 3 s (`auth_failed`).
- Reads (`info`, `list`, `get`, `validate`, …), control ops (`select`, `start`, `stop`, `reboot`, …), MaxLoop
  and USB stay open. The PIN travels in clear text.
