RunningJoke/reactionButton/hardware/pcb/PCB Board/20250308_octopart_sourced_bom.csv

Query | Qty | Manufacturer | MPN | Octopart URL | Part Description | Description | Schematic Reference | Internal Part Number | Lifecycle | Lead Time | RoHS | Total Qty (@ Batch Size: 1) | SKU | SKU | SKU | SKU | SKU | Packaging | Packaging | Packaging | Packaging | Packaging | Unit Price (@ Batch Size: 1) | Unit Price (@ Batch Size: 1) | Unit Price (@ Batch Size: 1) | Unit Price (@ Batch Size: 1) | Unit Price (@ Batch Size: 1) | In Stock | In Stock | In Stock | In Stock | In Stock | MOQ | MOQ | MOQ | MOQ | MOQ | URL | URL | URL | URL | URL | Distributor [Lowest Price (Preferred Distributors)] | SKU [Lowest Price (Preferred Distributors)] | Packaging [Lowest Price (Preferred Distributors)] | Unit Price (@ Batch Size: 1) [Lowest Price (Preferred Distributors)] | Line Total [Lowest Price (Preferred Distributors)] | Batch Total [Lowest Price (Preferred Distributors)] | In Stock [Lowest Price (Preferred Distributors)] | MOQ [Lowest Price (Preferred Distributors)] | URL [Lowest Price (Preferred Distributors)] | Notes
 |  |  |  |  |  |  |  |  |  |  |  |  | Digi-Key | Mouser | Newark | Onlinecomponents.com | RS Components | Digi-Key | Mouser | Newark | Onlinecomponents.com | RS Components | Digi-Key | Mouser | Newark | Onlinecomponents.com | RS Components | Digi-Key | Mouser | Newark | Onlinecomponents.com | RS Components | Digi-Key | Mouser | Newark | Onlinecomponents.com | RS Components | Digi-Key | Mouser | Newark | Onlinecomponents.com | RS Components
TL3305BF100QG | 6 | E-Switch | TL3305BF100QG | https://octopart.com/tl3305bf100qg-e-switch-155497924 | TL3305 Ultra-Miniature Tact Switch 100gf 5.0mm actuator Silver Contact Gullwing |  | SW2,SW1,SW6,SW5,SW4,SW3 |  |  | 14w | Compliant | 6 | 141-TL3305BF100QGCT-ND | 612-TL3305BF100QG | 12AM4406 | TL3305BF100QG |  | Cut Tape | Tape & Reel | Cut Tape | Bulk |  | 0.26 | 0.17 | 0.25 |  |  | 2639 | 10994 | 0 | 0 |  | 1 | 1 | 1 | 1500 |  | https://octopart.com/opatz8j6/a1 | https://octopart.com/opatz8j6/a1 | https://octopart.com/opatz8j6/a1 | https://octopart.com/opatz8j6/a1 |  | Mouser | 612-TL3305BF100QG | Tape & Reel | 0.17 | 1.02 | 1.02 | 10994 | 1 | https://octopart.com/opatz8j6/a1
TP4057 | 1 | UMW(Youtai Semiconductor Co., Ltd.) | TP4057 | https://octopart.com/tp4057-umw%28youtai+semiconductor+co.%2C+ltd.%29-121754010 | 6.5V /Polymer 1 500mA SOT-23-6 Battery Management ICs ROHS |  | U3 |  |  | 8w |  | 1 | 4518-TP4057CT-ND |  |  |  |  | Cut Tape |  |  |  |  | 0.5957597073628318 |  |  |  |  | 3000 |  |  |  |  | 1 |  |  |  |  | https://octopart.com/opatz8j6/a1 |  |  |  |  | DigiKey | 4518-TP4057CT-ND | Cut Tape | 0.5957597073628318 | 0.5957597073628318 | 0.5957597073628318 | 3000 | 1 | https://octopart.com/opatz8j6/a1
ESP32-C3-MINI-1-H4 | 1 | Espressif Systems | ESP32-C3-MINI-1-H4 | https://octopart.com/esp32-c3-mini-1-h4-espressif+systems-116589974 | Multiprotocol Modules SMD module, ESP32-C3FH4, PCB antenna, -40 C +105 C |  | U1 |  |  | 12w | Compliant | 1 | 1965-ESP32-C3-MINI-1-H4CT-ND | 356-ESP32-C3-MINI1H4 |  |  |  | Cut Tape | Tape & Reel |  |  |  | 3.28 | 1.9 |  |  |  | 16472 | 0 |  |  |  | 1 | 1 |  |  |  | https://octopart.com/opatz8j6/a1 | https://octopart.com/opatz8j6/a1 |  |  |  | Mouser | 356-ESP32-C3-MINI1H4 | Tape & Reel | 1.9 | 1.9 | 1.9 | 0 | 1 | https://octopart.com/opatz8j6/a1
CRCW04022K00FKEDHP | 1 | Vishay | CRCW04022K00FKEDHP | https://octopart.com/crcw04022k00fkedhp-vishay-44382936 | Res Thick Film 0402 2K Ohm 1% 0.2W(1/5W) ±100ppm/C Pad SMD Automotive T/R |  | R14 |  |  | 19w | Compliant | 1 | 541-2.00KYDKR-ND | 71-CRCW04022K00FKEDH | 65AC3353 |  | 8121635 | Custom Reel | Tape & Reel | Cut Tape |  | Bag | 0.11915194147256634 | 0.1 | 0.016 |  |  | 72515 | 134639 | 4092 |  | 200 | 1 | 1 | 1 |  | 100 | https://octopart.com/opatz8j6/a1 | https://octopart.com/opatz8j6/a1 | https://octopart.com/opatz8j6/a1 |  | https://octopart.com/opatz8j6/a1 | Newark | 65AC3353 | Cut Tape | 0.016 | 0.016 | 0.016 | 4092 | 1 | https://octopart.com/opatz8j6/a1
CRCW040210K0FKEDC | 6 | Vishay | CRCW040210K0FKEDC | https://octopart.com/crcw040210k0fkedc-vishay-12144431 | Res Thick Film 0402 10K Ohm 1% 0.063W(1/16W) ±100ppm/C Pad SMD T/R |  | R13,R11,R10,R5,R4,R1 |  |  | 18w | Compliant | 6 | 541-3959-1-ND | 71-CRCW040210K0FKEDC | 65AC3344 |  |  | Cut Tape | Tape & Reel | Cut Tape |  |  | 0.1 | 0.1 | 0.006 |  |  | 3409982 | 6050918 | 8876 |  |  | 1 | 1 | 1 |  |  | https://octopart.com/opatz8j6/a1 | https://octopart.com/opatz8j6/a1 | https://octopart.com/opatz8j6/a1 |  |  | Newark | 65AC3344 | Cut Tape | 0.006 | 0.036000000000000004 | 0.036000000000000004 | 8876 | 1 | https://octopart.com/opatz8j6/a1
560112110231 | 1 | Wurth Elektronik | 560112110231 | https://octopart.com/560112110231-wurth+elektronik-145532915 | Resistor, 330R, 0.1W, Thick Film, 0402 Rohs Compliant: Yes |  | R12 |  |  | 28w |  | 1 | 732-560112110231CT-ND | 710-560112110231 | 90AK5283 |  |  | Cut Tape | Tape & Reel | Cut Tape |  |  | 0.1 | 0.1 |  |  |  | 9521 | 11988 | 4656 |  |  | 1 | 1 | 10 |  |  | https://octopart.com/opatz8j6/a1 | https://octopart.com/opatz8j6/a1 | https://octopart.com/opatz8j6/a1 |  |  | DigiKey | 732-560112110231CT-ND | Cut Tape | 0.1 | 0.1 | 0.1 | 9521 | 1 | https://octopart.com/opatz8j6/a1
MCS0402MD1003BE000 | 4 | Vishay | MCS0402MD1003BE000 | https://octopart.com/mcs0402md1003be000-vishay-92403075 | Mcs 0402-25 0.1% At E0 100K |  | R9,R8,R7,R6 |  |  |  |  | 4 |  | 594-MCS0402MD1003BE0 |  |  |  |  |  |  |  |  |  | 0.36 |  |  |  |  | 6882 |  |  |  |  | 1 |  |  |  |  | https://octopart.com/opatz8j6/a1 |  |  |  | Mouser | 594-MCS0402MD1003BE0 |  | 0.36 | 1.44 | 1.44 | 6882 | 1 | https://octopart.com/opatz8j6/a1
MCS04020C5101FE000 | 2 | Vishay | MCS04020C5101FE000 | https://octopart.com/mcs04020c5101fe000-vishay-44468370 | MCS - Professional FIXED RESISTOR 0402 (1005Metric) Chip Resistor ±1% ±50ppm/C 5.1kOhm 0.1W 1/10W |  | R3,R2 |  |  | 12w | Compliant | 2 | 231227515102-ND | 594-MCS04020C5101FE0 | 06AJ9557 |  |  | Tape & Reel | Tape & Reel |  |  |  |  | 0.16 |  |  |  | 0 | 25783 | 0 |  |  | 10000 | 1 | 10000 |  |  | https://octopart.com/opatz8j6/a1 | https://octopart.com/opatz8j6/a1 | https://octopart.com/opatz8j6/a1 |  |  | Mouser | 594-MCS04020C5101FE0 | Tape & Reel | 0.16 | 0.32 | 0.32 | 25783 | 1 | https://octopart.com/opatz8j6/a1
BSS138 | 1 | onsemi | BSS138 | https://octopart.com/bss138-onsemi-19021258 | Trans MOSFET N Channel 50 Volt 0.22A 3-Pin SOT-23 Tape and Reel |  | Q2 |  | Production (Last Updated: 4 years ago) | 13w | Compliant | 1 | BSS138CT-ND | 512-BSS138 | 58K8769 | BSS138 | 6710324P | Cut Tape | Tape & Reel | Cut Tape | Bulk | Custom Reel | 0.28163186166242954 | 0.27 | 0.232 |  |  | 120342 | 569304 | 14728 | 54000 | 176750 | 1 | 1 | 1 | 3000 | 100 | https://octopart.com/opatz8j6/a1 | https://octopart.com/opatz8j6/a1 | https://octopart.com/opatz8j6/a1 | https://octopart.com/opatz8j6/a1 | https://octopart.com/opatz8j6/a1 | Newark | 58K8769 | Cut Tape | 0.232 | 0.232 | 0.232 | 14728 | 1 | https://octopart.com/opatz8j6/a1
FDN340P | 1 | onsemi | FDN340P | https://octopart.com/fdn340p-onsemi-84326388 | Power MOSFET, P Channel, 20 V, 2 A, 70 MilliOhms, SOT-23 (TO-236), 3 Pins, Surface Mount |  | Q1 |  | Production (Last Updated: 4 years ago) | 24w | Compliant | 1 | FDN340PCT-ND | 512-FDN340P | 58K8841 | FDN340P |  | Cut Tape | Tape & Reel | Cut Tape | Bulk |  | 0.5740957180041834 | 0.51 | 0.142 |  |  | 19786 | 35967 | 20244 | 27000 |  | 1 | 1 | 1 | 3000 |  | https://octopart.com/opatz8j6/a1 | https://octopart.com/opatz8j6/a1 | https://octopart.com/opatz8j6/a1 | https://octopart.com/opatz8j6/a1 |  | Newark | 58K8841 | Cut Tape | 0.142 | 0.142 | 0.142 | 20244 | 1 | https://octopart.com/opatz8j6/a1
S2B-PH-K-S | 1 | JST | S2B-PH-K-S(LF)(SN) | https://octopart.com/s2b-ph-k-s%28lf%29%28sn%29-jst-248883 | Header for PCB; pitch 2.00mm; 2-contacts; THT; male; side entry; 100V/2A |  | J2 |  |  |  | Compliant | 1 |  | 306-S2BPHKSLFSNPP | 38K8066 |  | 8201494P |  |  |  |  | Bag |  | 0.1 | 0.038 |  |  |  | 0 | 605693 |  | 27005 |  | 1 | 1 |  | 125 |  | https://octopart.com/opatz8j6/a1 | https://octopart.com/opatz8j6/a1 |  | https://octopart.com/opatz8j6/a1 | Newark | 38K8066 |  | 0.038 | 0.038 | 0.038 | 605693 | 1 | https://octopart.com/opatz8j6/a1
USB4105 | 1 | Global Connector Technology | USB4135-GF-A | https://octopart.com/usb4135-gf-a-global+connector+technology-126125931 | USB Connector, TYPE C, R/A RCPT, 6POS, SMT; U; Connector Type: USB Type C; Standard: -; |  | J1 |  |  | 9w | Compliant | 1 | 2073-USB4135-GF-ACT-ND |  | 27AK1392 |  |  | Cut Tape |  | Cut Tape |  |  | 0.67 |  | 0.44 |  |  | 1584 |  | 1184 |  |  | 1 |  | 1 |  |  | https://octopart.com/opatz8j6/a1 |  | https://octopart.com/opatz8j6/a1 |  |  | Newark | 27AK1392 | Cut Tape | 0.44 | 0.44 | 0.44 | 1184 | 1 | https://octopart.com/opatz8j6/a1
COM-24837 | 20 | SparkFun | COM-24837 | https://octopart.com/com-24837-sparkfun-147356944 | WS2812B SMD Address Rgb Led Ct |  | D23,D22,D21,D20,D19,D18,D17,D16,D15,D14,D13,D12,D11,D10,D9,D8,D7,D6,D5,D4 |  |  | 5w |  | 20 | 1568-COM-24837-ND | 474-COM-24837 |  | COM-24837 |  | Strip |  |  | Bulk |  | 0.75 | 0.75 |  |  |  | 342 | 1880 |  | 0 |  | 1 | 1 |  | 25 |  | https://octopart.com/opatz8j6/a1 | https://octopart.com/opatz8j6/a1 |  | https://octopart.com/opatz8j6/a1 |  | DigiKey | 1568-COM-24837-ND | Strip | 0.75 | 15 | 15 | 342 | 1 | https://octopart.com/opatz8j6/a1
150040BS73220 | 1 | Wurth Elektronik | 150040BS73220 | https://octopart.com/150040bs73220-wurth+elektronik-98667829 | WL-SMCC SMT Mono-color Chip LED compact |  | D3 |  |  | 9w | Compliant | 1 | 732-13427-1-ND | 710-150040BS73220 | 95AC2578 |  | 1847335 | Cut Tape | Tape & Reel | Cut Tape |  | Ammo Pack | 0.4766077658902654 | 0.51 | 0.53 |  |  | 9876 | 5235 | 2761 |  | 0 | 1 | 1 | 1 |  | 25 | https://octopart.com/opatz8j6/a1 | https://octopart.com/opatz8j6/a1 | https://octopart.com/opatz8j6/a1 |  | https://octopart.com/opatz8j6/a1 | DigiKey | 732-13427-1-ND | Cut Tape | 0.4766077658902654 | 0.4766077658902654 | 0.4766077658902654 | 9876 | 1 | https://octopart.com/opatz8j6/a1
150040VS73220 | 1 | Wurth Elektronik | 150040VS73220 | https://octopart.com/150040vs73220-wurth+elektronik-98667833 | WL-SMCC SMT Mono-color Chip LED compact |  | D2 |  |  | 8w | Compliant | 1 | 732-13425-1-ND | 710-150040VS73220 | 95AC2582 |  | 1847328P | Cut Tape | Tape & Reel | Cut Tape |  | Custom Reel | 0.4766077658902654 | 0.51 | 0.53 |  |  | 1680 | 3087 | 4039 |  | 876 | 1 | 1 | 1 |  | 100 | https://octopart.com/opatz8j6/a1 | https://octopart.com/opatz8j6/a1 | https://octopart.com/opatz8j6/a1 |  | https://octopart.com/opatz8j6/a1 | DigiKey | 732-13425-1-ND | Cut Tape | 0.4766077658902654 | 0.4766077658902654 | 0.4766077658902654 | 1680 | 1 | https://octopart.com/opatz8j6/a1
SS14 | 1 | onsemi | RB521S30T1G | https://octopart.com/rb521s30t1g-onsemi-332928 | Small Signal Schottky Diode, Single, 30 V, 200 mA, 500 mV, 1 A, 125 ï¿½C, SOD-523, 2 Pins |  | D1 |  | Production (Last Updated: 4 years ago) | 5w | Compliant | 1 | RB521S30T1GOSCT-ND | 863-RB521S30T1G | 10N9731 | RB521S30T1G | 7916325P | Cut Tape | Tape & Reel | Cut Tape | Bulk | Custom Reel | 0.10831994679324214 | 0.1 | 0.02 |  |  | 56217 | 305901 | 3466 | 180000 | 7300 | 1 | 1 | 1 | 30000 | 500 | https://octopart.com/opatz8j6/a1 | https://octopart.com/opatz8j6/a1 | https://octopart.com/opatz8j6/a1 | https://octopart.com/opatz8j6/a1 | https://octopart.com/opatz8j6/a1 | Newark | 10N9731 | Cut Tape | 0.02 | 0.02 | 0.02 | 3466 | 1 | https://octopart.com/opatz8j6/a1
GRM022R60J104ME01L | 20 | Murata | GRM022R60J104ME01L | https://octopart.com/grm022r60j104me01l-murata-106704705 | Multi-Layer Ceramic Capacitor 0.1uF 6.3VDC X5R 20% 01005 Emboss T/R |  | C25,C24,C23,C22,C21,C20,C19,C18,C17,C16,C15,C14,C13,C12,C11,C10,C9,C8,C7,C6 |  | Production (Last Updated: 4 years ago) | 10w | Compliant | 20 | 490-GRM022R60J104ME01LDKR-ND | 81-GRM022R60J104ME1L |  |  |  | Custom Reel | Tape & Reel |  |  |  | 0.028163186166242953 | 0.032 |  |  |  | 0 | 82736 |  |  |  | 1 | 1 |  |  |  | https://octopart.com/opatz8j6/a1 | https://octopart.com/opatz8j6/a1 |  |  |  | DigiKey | 490-GRM022R60J104ME01LDKR-ND | Custom Reel | 0.028163186166242953 | 0.5632637233248591 | 0.5632637233248591 | 0 | 1 | https://octopart.com/opatz8j6/a1
CGA3EDX7T1A106M080AU | 2 | TDK | CGA3EDX7T1A106M080AU | https://octopart.com/cga3edx7t1a106m080au-tdk-148995611 | Cap Cer 10UF 10V X7T 0603 |  | C5,C2 |  |  | 11w |  | 2 | 445-CGA3EDX7T1A106M080AUCT-ND | 810-CGA3EDX7T1A106M0 |  |  |  | Cut Tape | Tape & Reel |  |  |  | 0.45 | 0.49 |  |  |  | 6202 | 11384 |  |  |  | 1 | 1 |  |  |  | https://octopart.com/opatz8j6/a1 | https://octopart.com/opatz8j6/a1 |  |  |  | DigiKey | 445-CGA3EDX7T1A106M080AUCT-ND | Cut Tape | 0.45 | 0.9 | 0.9 | 6202 | 1 | https://octopart.com/opatz8j6/a1
KAF21KR71E225KU | 1 | AVX | 08053C225K4Z2A | https://octopart.com/08053c225k4z2a-avx-122050378 | Multilayer Ceramic Capacitor, 2.2 uF, 25 V, ï¿½ 10%, X7R, 0805 [2012 Metric] |  | C4 |  |  | 14w | Compliant | 1 | 478-KAF21KR71E225KUDKR-ND | 581-08053C225K4Z2A | 47AC9930 |  |  | Custom Reel | Tape & Reel | Cut Tape |  |  | 0.33579183505905064 | 0.33 | 0.022 |  |  | 6646 | 6002 | 20 |  |  | 1 | 1 | 1 |  |  | https://octopart.com/opatz8j6/a1 | https://octopart.com/opatz8j6/a1 | https://octopart.com/opatz8j6/a1 |  |  | Newark | 47AC9930 | Cut Tape | 0.022 | 0.022 | 0.022 | 20 | 1 | https://octopart.com/opatz8j6/a1
MAASL105CC7105MFCA01 | 2 | Taiyo Yuden | MAASL105CC7105MFCA01 | https://octopart.com/maasl105cc7105mfca01-taiyo+yuden-148348556 | Cap Cer 1UF 20V X7S 0402 |  | C3,C1 |  |  | 13w |  | 2 | 587-MAASL105CC7105MFCA01CT-ND | 963-MAASL105CC7105MF |  | MAASL105CC7105MFCA01 |  | Cut Tape | Tape & Reel |  | Bulk |  | 0.12998393615189055 | 0.14 |  |  |  | 6319 | 10948 |  | 0 |  | 1 | 1 |  | 10000 |  | https://octopart.com/opatz8j6/a1 | https://octopart.com/opatz8j6/a1 |  | https://octopart.com/opatz8j6/a1 |  | DigiKey | 587-MAASL105CC7105MFCA01CT-ND | Cut Tape | 0.12998393615189055 | 0.2599678723037811 | 0.2599678723037811 | 6319 | 1 | https://octopart.com/opatz8j6/a1
TLV75533PDYDR | 1 | Texas Instruments | TLV75533PDYDR | https://octopart.com/tlv75533pdydr-texas+instruments-147796865 | 500mA high-PSRR low-IQ low-dropout voltage regulator with enable 5-SOT-23 -40 to 125 |  |  |  | Production (Last Updated: 6 days ago) | 12w | Compliant | 1 | 296-TLV75533PDYDRCT-ND | 595-TLV75533PDYDR |  |  |  | Cut Tape | Tape & Reel |  |  |  | 0.2599678723037811 | 0.25 |  |  |  | 1930 | 2429 |  |  |  | 1 | 1 |  |  |  | https://octopart.com/opatz8j6/a1 | https://octopart.com/opatz8j6/a1 |  |  |  | Mouser | 595-TLV75533PDYDR | Tape & Reel | 0.25 | 0.25 | 0.25 | 2429 | 1 | https://octopart.com/opatz8j6/a1
