RunningJoke/reactionButton/cad/casing/Casing_slim/slimCasing_new-Unterteil.stl

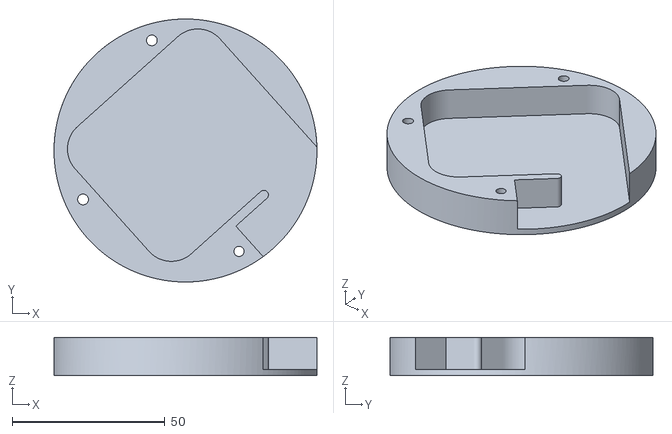
[picture p3: CAD file, 2025-05-25]
cad/casing/Casing_slim/slimCasing_new-Unterteil.stl
86.0 x 86.0 x 12.5
