RunningJoke/reactionButton/cad/casing/slimCasing_new-Buzzerkopf.3mf

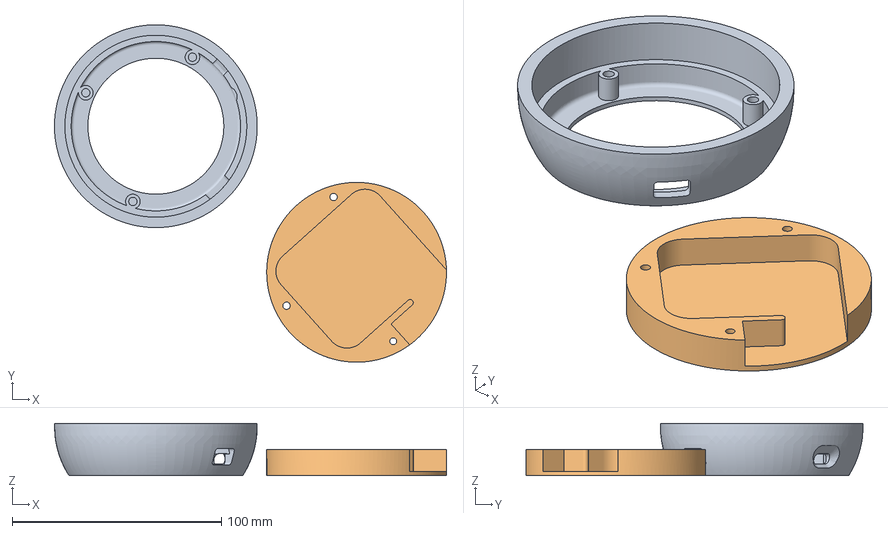
[picture p4: CAD file, 2026-10-19]
cad/casing/slimCasing_new-Buzzerkopf.3mf
187.5 x 161.4 x 25.1 mm
casing_v4-Aussenl.stl
casing_v4-Innenteil.stl
