RunningJoke/reactionButton/cad/pcb/PCB Board/additionalData/BOB-12009/BOB-12009.step

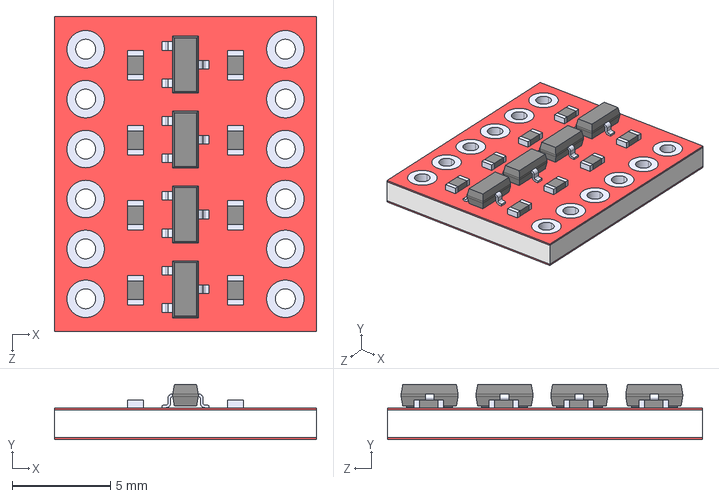
[picture p5: CAD file, 2024-03-03]
cad/pcb/PCB Board/additionalData/BOB-12009/BOB-12009.step
13.3 x 2.80 x 16.1 mm
