RunningJoke/reactionButton/hardware/casing/casing_v4-Aussenl.stl

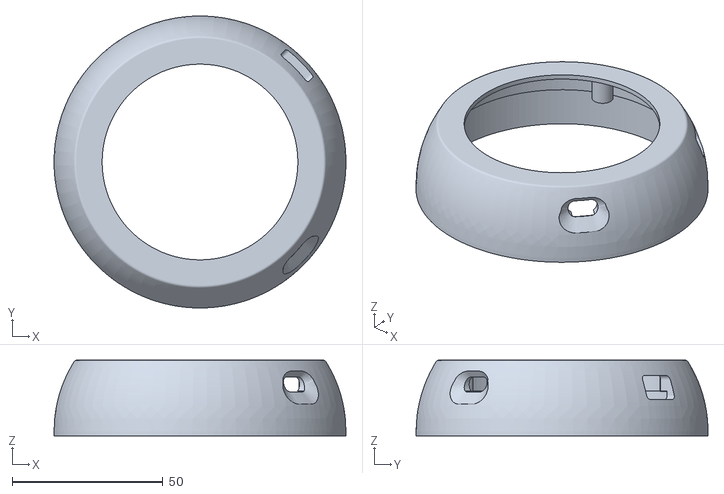
[picture p6: CAD file, 2026-10-19]
hardware/casing/casing_v4-Aussenl.stl
97.0 x 97.0 x 25.1
