RunningJoke/reactionButton/cad/casing/slimCasing_new.FCStd

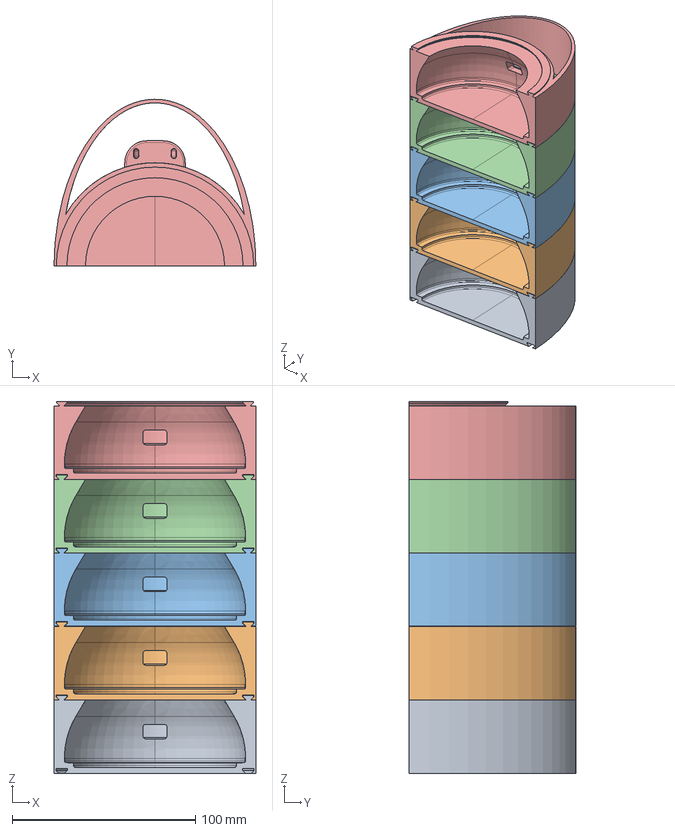
[picture p7: CAD file, 2026-10-19]
cad/casing/slimCasing_new.FCStd
110.0 x 90.8 x 202.8 mm
Ladestation
