RunningJoke/reactionButton/hardware/casing/PCB Board.stl

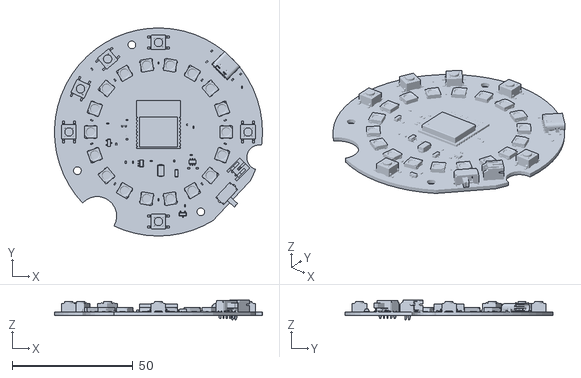
[picture p8: CAD file, 2026-10-19]
hardware/casing/PCB Board.stl
86.0 x 86.0 x 8.25
