RunningJoke/reactionButton/cad/casing/Casing_slim/slimCasing_new.FCStd

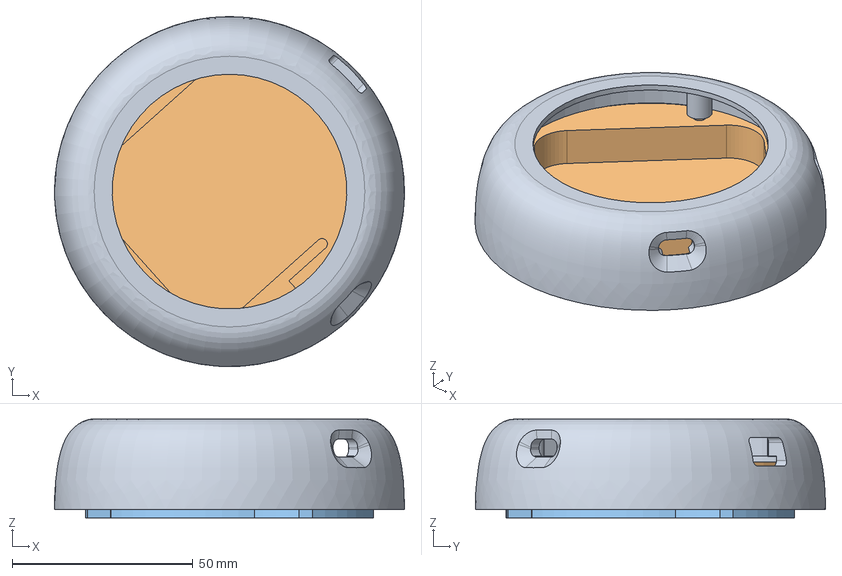
[picture p9: CAD file, 2025-05-25]
cad/casing/Casing_slim/slimCasing_new.FCStd
97.0 x 97.0 x 27.4 mm
Aussenhuelle
Unterteil
Antirutschfuesse
