RunningJoke/reactionButton/cad/casing/casing_v2-BuzzerknopfLED_zentral.stl

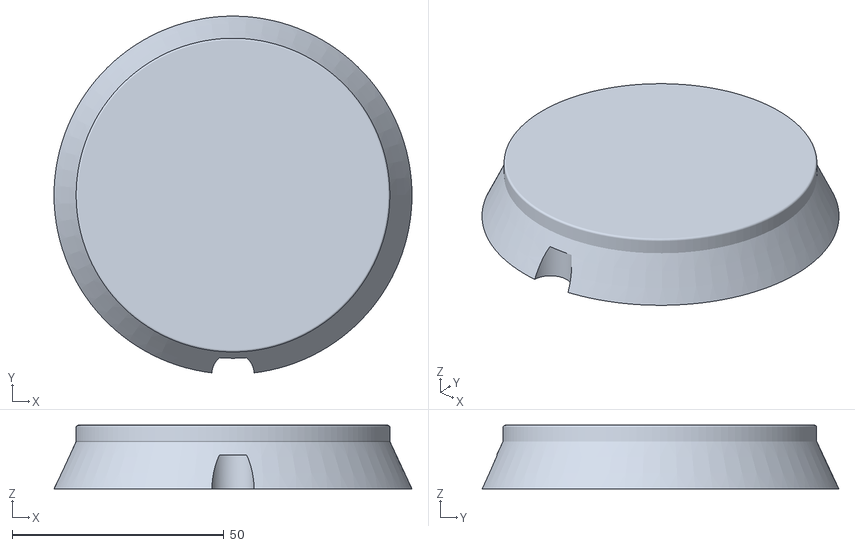
[picture p10: CAD file, 2024-04-06]
cad/casing/casing_v2-BuzzerknopfLED_zentral.stl
84.4 x 84.1 x 15.0
