RunningJoke/reactionButton/hardware/casing/casing_v4-Buzzerkopfl.stl

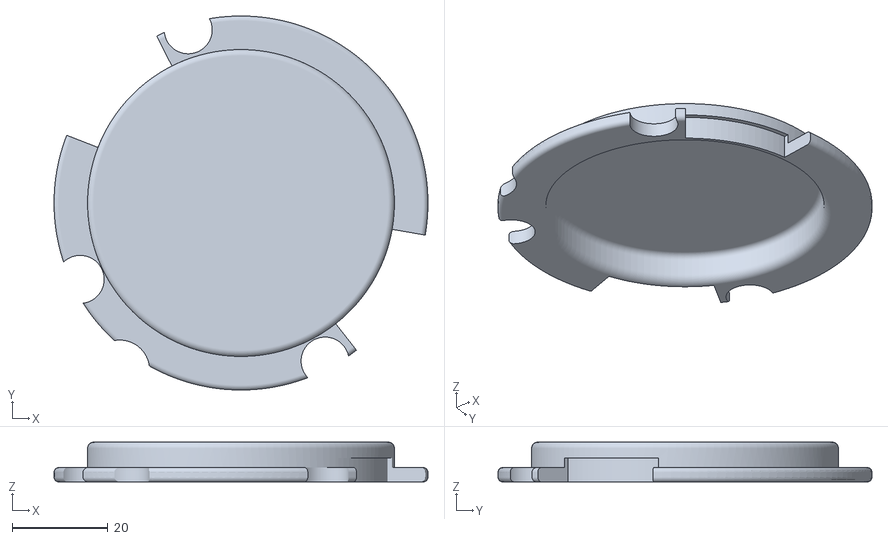
[picture p11: CAD file, 2026-10-19]
hardware/casing/casing_v4-Buzzerkopfl.stl
78.0 x 78.0 x 8.30
