RunningJoke/reactionButton/cad/casing/Casing_slim/slimCasing_new-Case.3mf

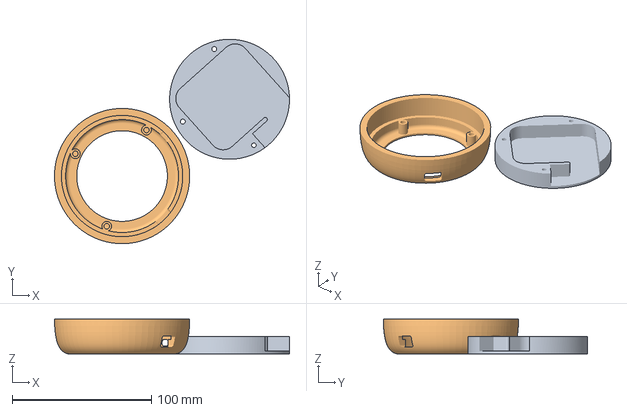
[picture p12: CAD file, 2025-05-25]
cad/casing/Casing_slim/slimCasing_new-Case.3mf
168.6 x 146.6 x 25.1 mm
slimCasing_new-Unterteil.stl
slimCasing_new-Aussenhuelle.stl
