RunningJoke/reactionButton/cad/casing/casing_v3-antirutschschablone.stl

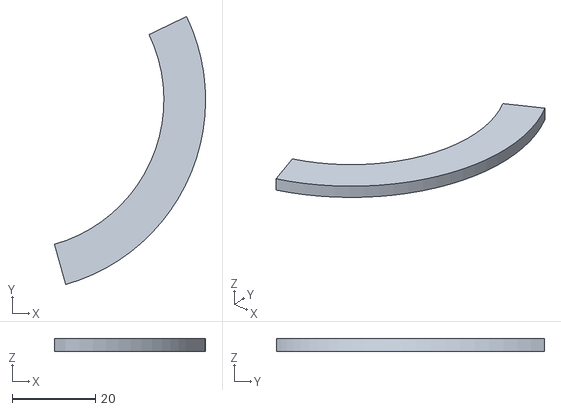
[picture p13: CAD file, 2024-04-06]
cad/casing/casing_v3-antirutschschablone.stl
36.2 x 64.2 x 3.00
