RunningJoke/reactionButton/cad/casing/casing_v2-LED-Mount.stl

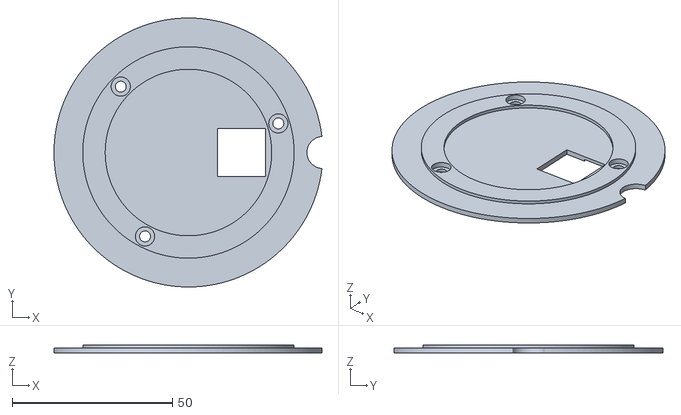
[picture p14: CAD file, 2024-04-06]
cad/casing/casing_v2-LED-Mount.stl
83.7 x 84.0 x 2.60
