RunningJoke/reactionButton/cad/casing/casing_v3-Innendeckel.stl

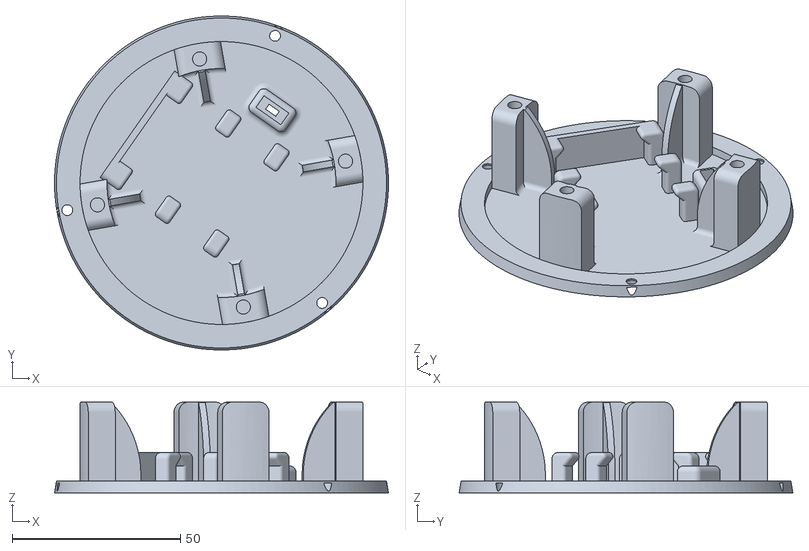
[picture p15: CAD file, 2024-04-06]
cad/casing/casing_v3-Innendeckel.stl
99.2 x 99.2 x 27.0
