RunningJoke/reactionButton/cad/casing/Casing_slim/slimCasing.FCStd

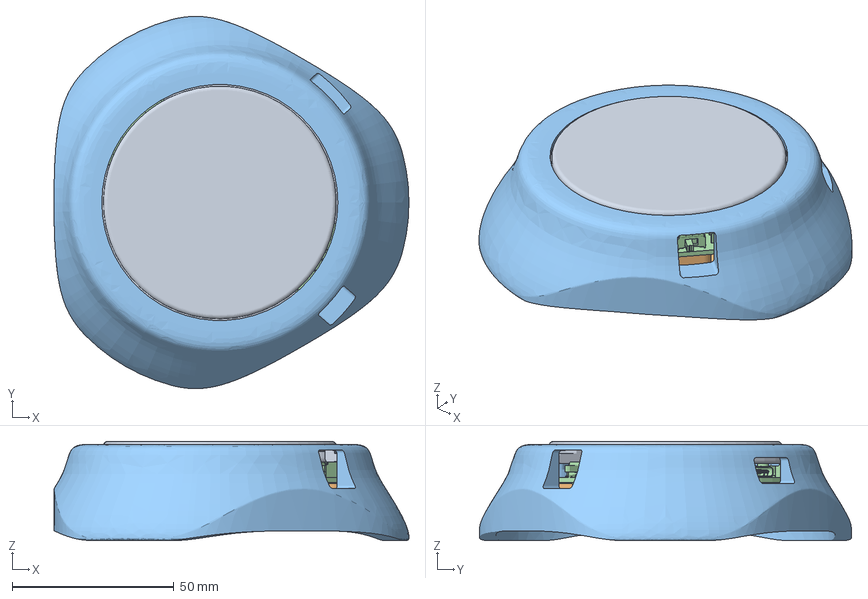
[picture p16: CAD file, 2025-04-06]
cad/casing/Casing_slim/slimCasing.FCStd
109.8 x 115.1 x 30.7 mm
Buzzerkopf
Innendeckel
Aussenhaut
PCB Board
