RunningJoke/reactionButton/cad/casing/casing_v3-Aussenhülle.stl

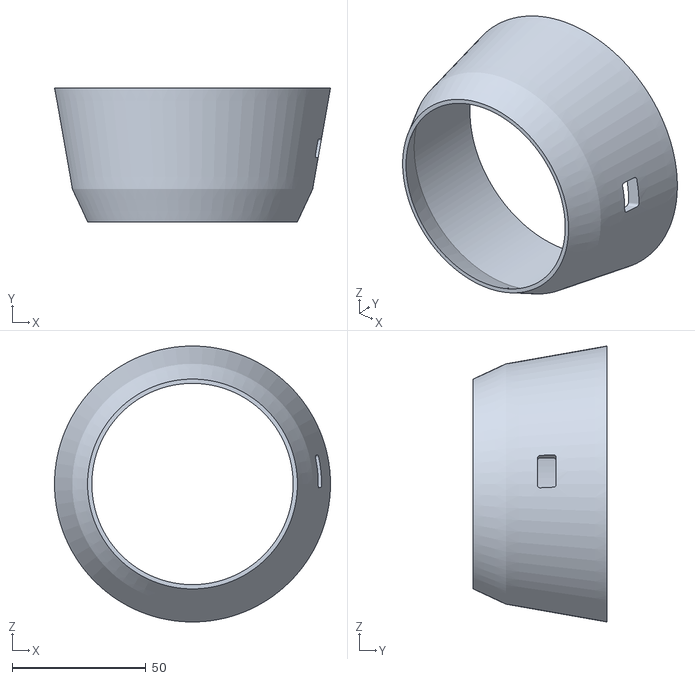
[picture p17: CAD file, 2024-04-06]
cad/casing/casing_v3-Aussenhülle.stl
103.1 x 50.0 x 103.1
