RunningJoke/reactionButton/cad/casing/Casing_slim/slimCasing-Case.3mf

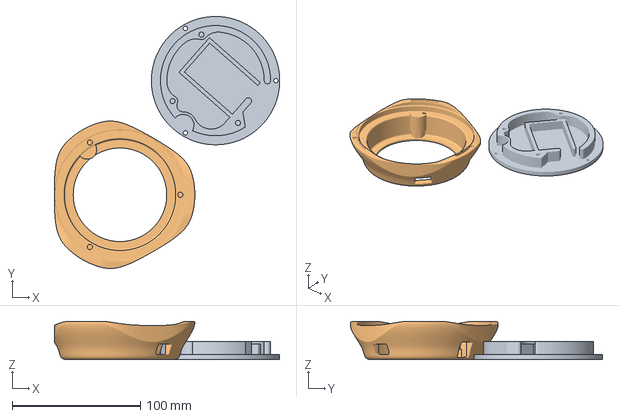
[picture p18: CAD file, 2025-04-03]
cad/casing/Casing_slim/slimCasing-Case.3mf
176.0 x 196.8 x 29.8 mm
slimCasing-Innendeckel.stl
slimCasing-Aussenhaut.stl
