RunningJoke/reactionButton/cad/casing/Casing_slim/slimCasing-Innendeckel.stl

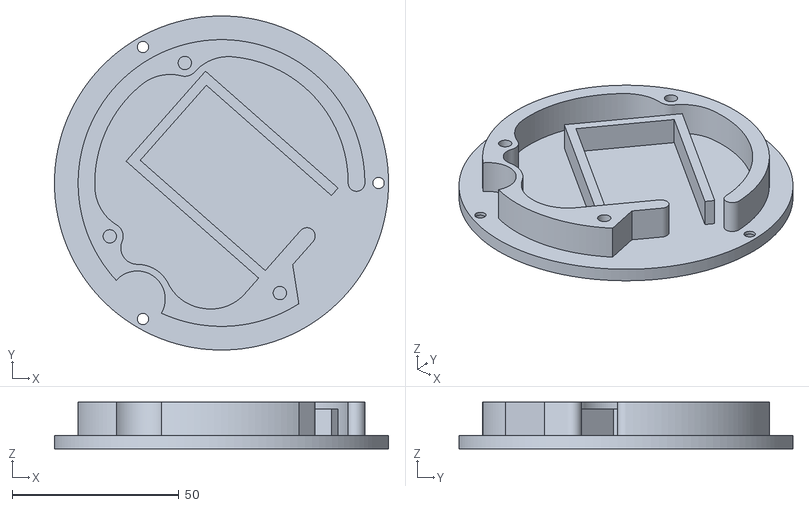
[picture p19: CAD file, 2025-04-03]
cad/casing/Casing_slim/slimCasing-Innendeckel.stl
100.2 x 100.2 x 14.0
