RunningJoke/reactionButton/cad/casing/Casing_slim/slimCasing-Aussenhaut.stl

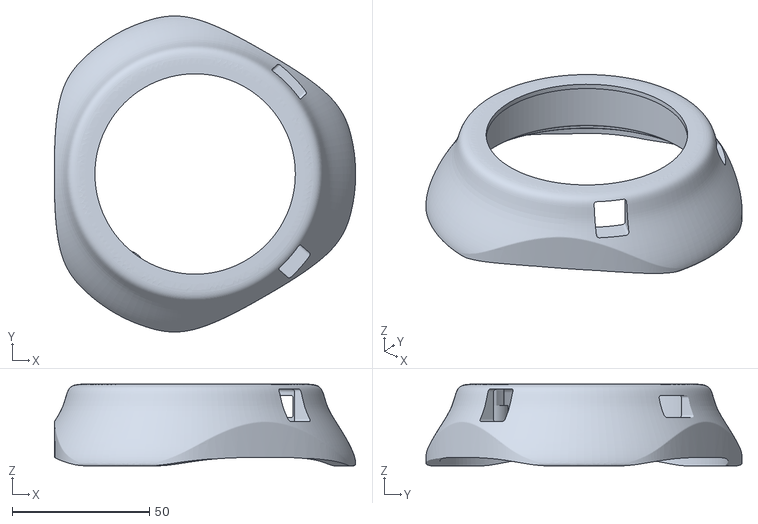
[picture p20: CAD file, 2025-04-03]
cad/casing/Casing_slim/slimCasing-Aussenhaut.stl
109.8 x 115.1 x 29.8
