RunningJoke/reactionButton/cad/casing/casing_v2.FCStd

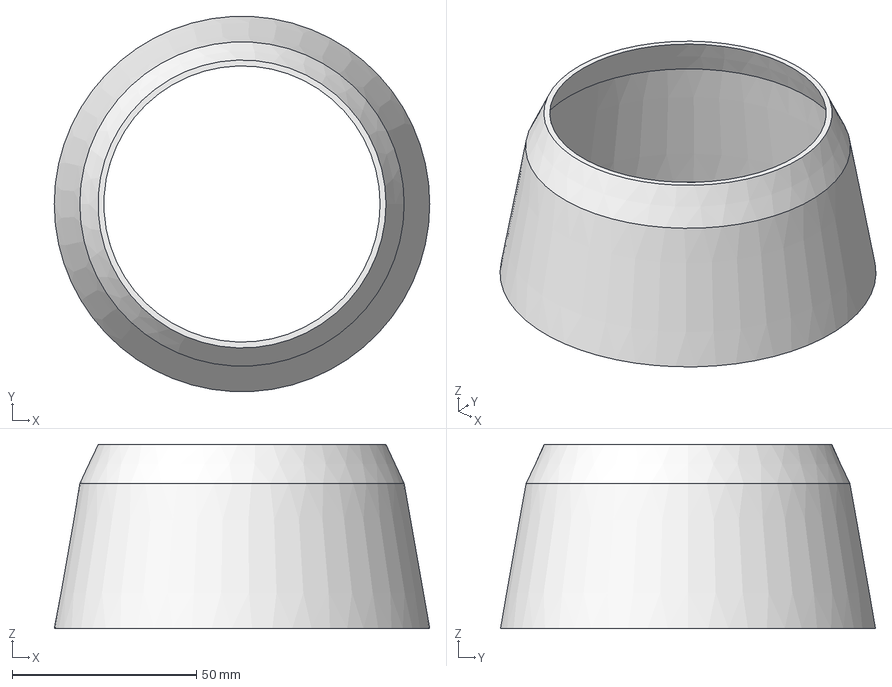
[picture p21: CAD file, 2024-03-03]
cad/casing/casing_v2.FCStd
102.0 x 101.8 x 50.0 mm
