RunningJoke/reactionButton/(list of files, cad)

Other CAD files:
hardware/pcb/PCB Board/PCB Board.step
cad/casing/Casing_slim/slimCasing_new-Aussenhuelle.stl
cad/casing/Casing_slim/slimCasing_new-Buzzerkopf.stl
cad/casing/Casing_slim/slimCasing_new-Buzzerhead.3mf
cad/casing/Casing_slim/slimCasing-Buzzerkopf.stl
cad/casing/casing_v1.FCStd
cad/casing/casing_v2-Aussenhülle.stl
cad/casing/casing_v2-Innendeckel.stl
