RunningJoke/reactionButton/cad/pcb/PCB Board/PCB Board.pdf

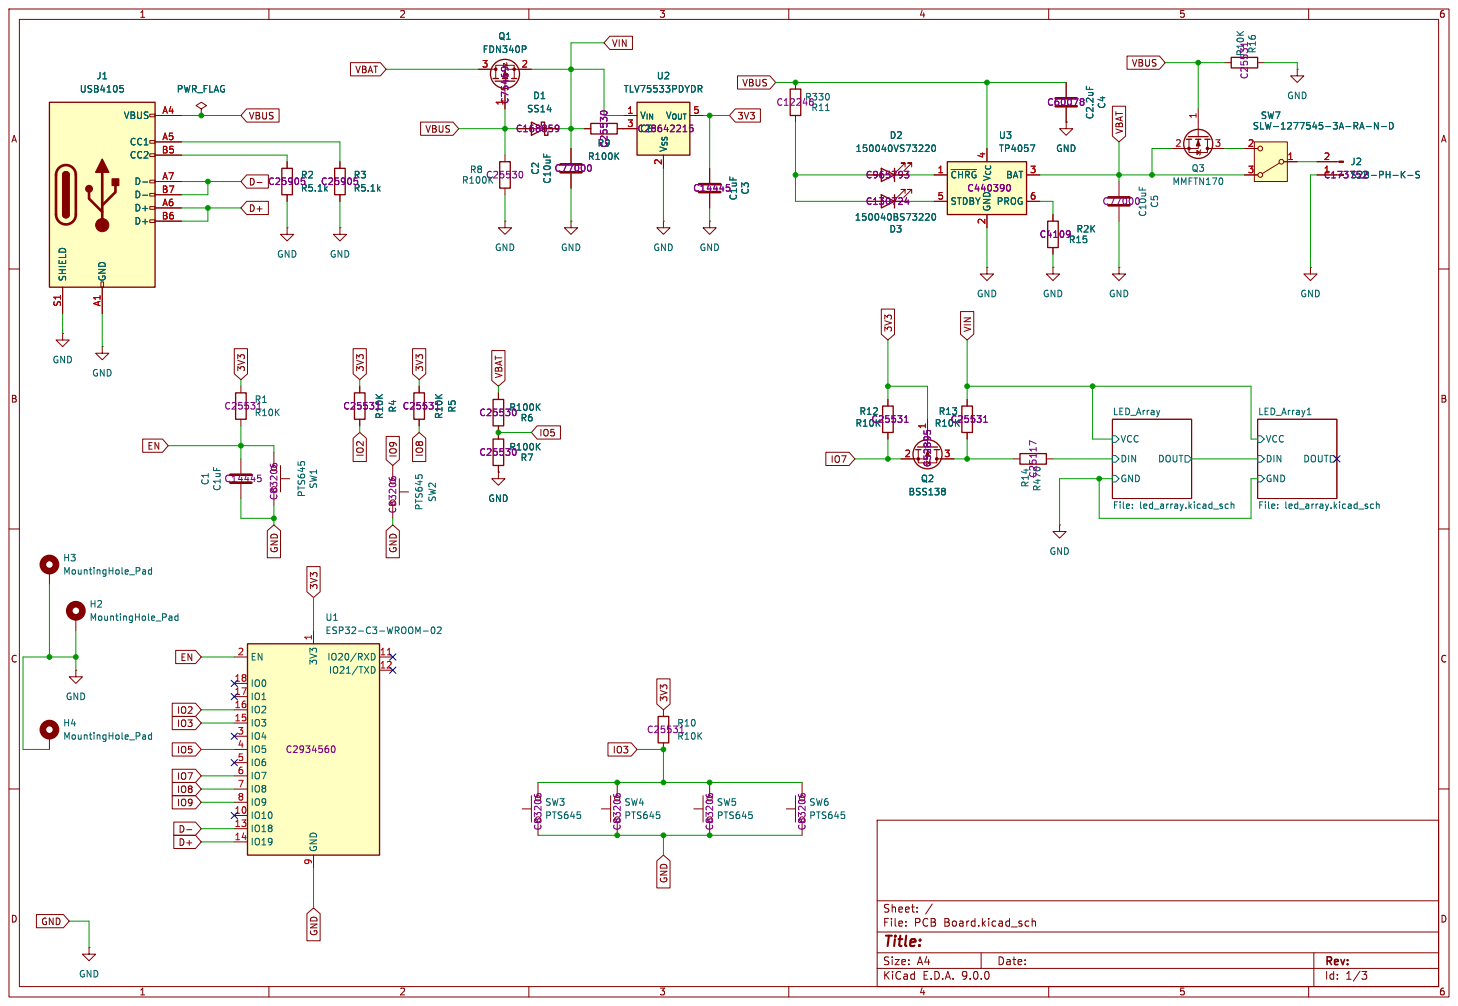
[picture p22: page 1]

2 SW7 SLW-1277545-3A-RA-N-D GND C5 C10uF C77000 GND

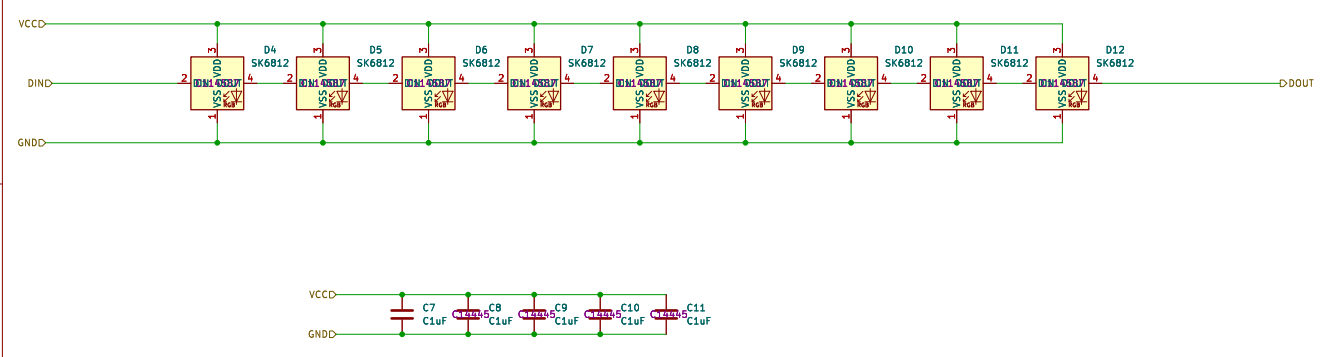
[picture p23: page 2]

Id: 2/3 Title: File: led_array.kicad_sch Sheet: /LED_Array/

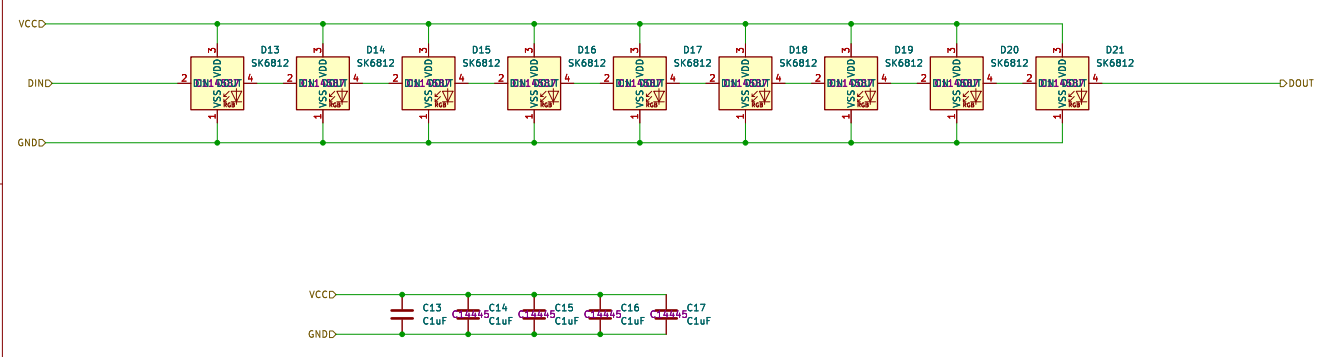
[picture p24: page 3]

Id: 3/3 Title: File: led_array.kicad_sch Sheet: /LED_Array1/
