RunningJoke/reactionButton/cad/pcb/PCB Board/PCB Board.kicad_pcb

## KiCad design cad/pcb/PCB Board/PCB Board.kicad_pcb (2025-04-03)

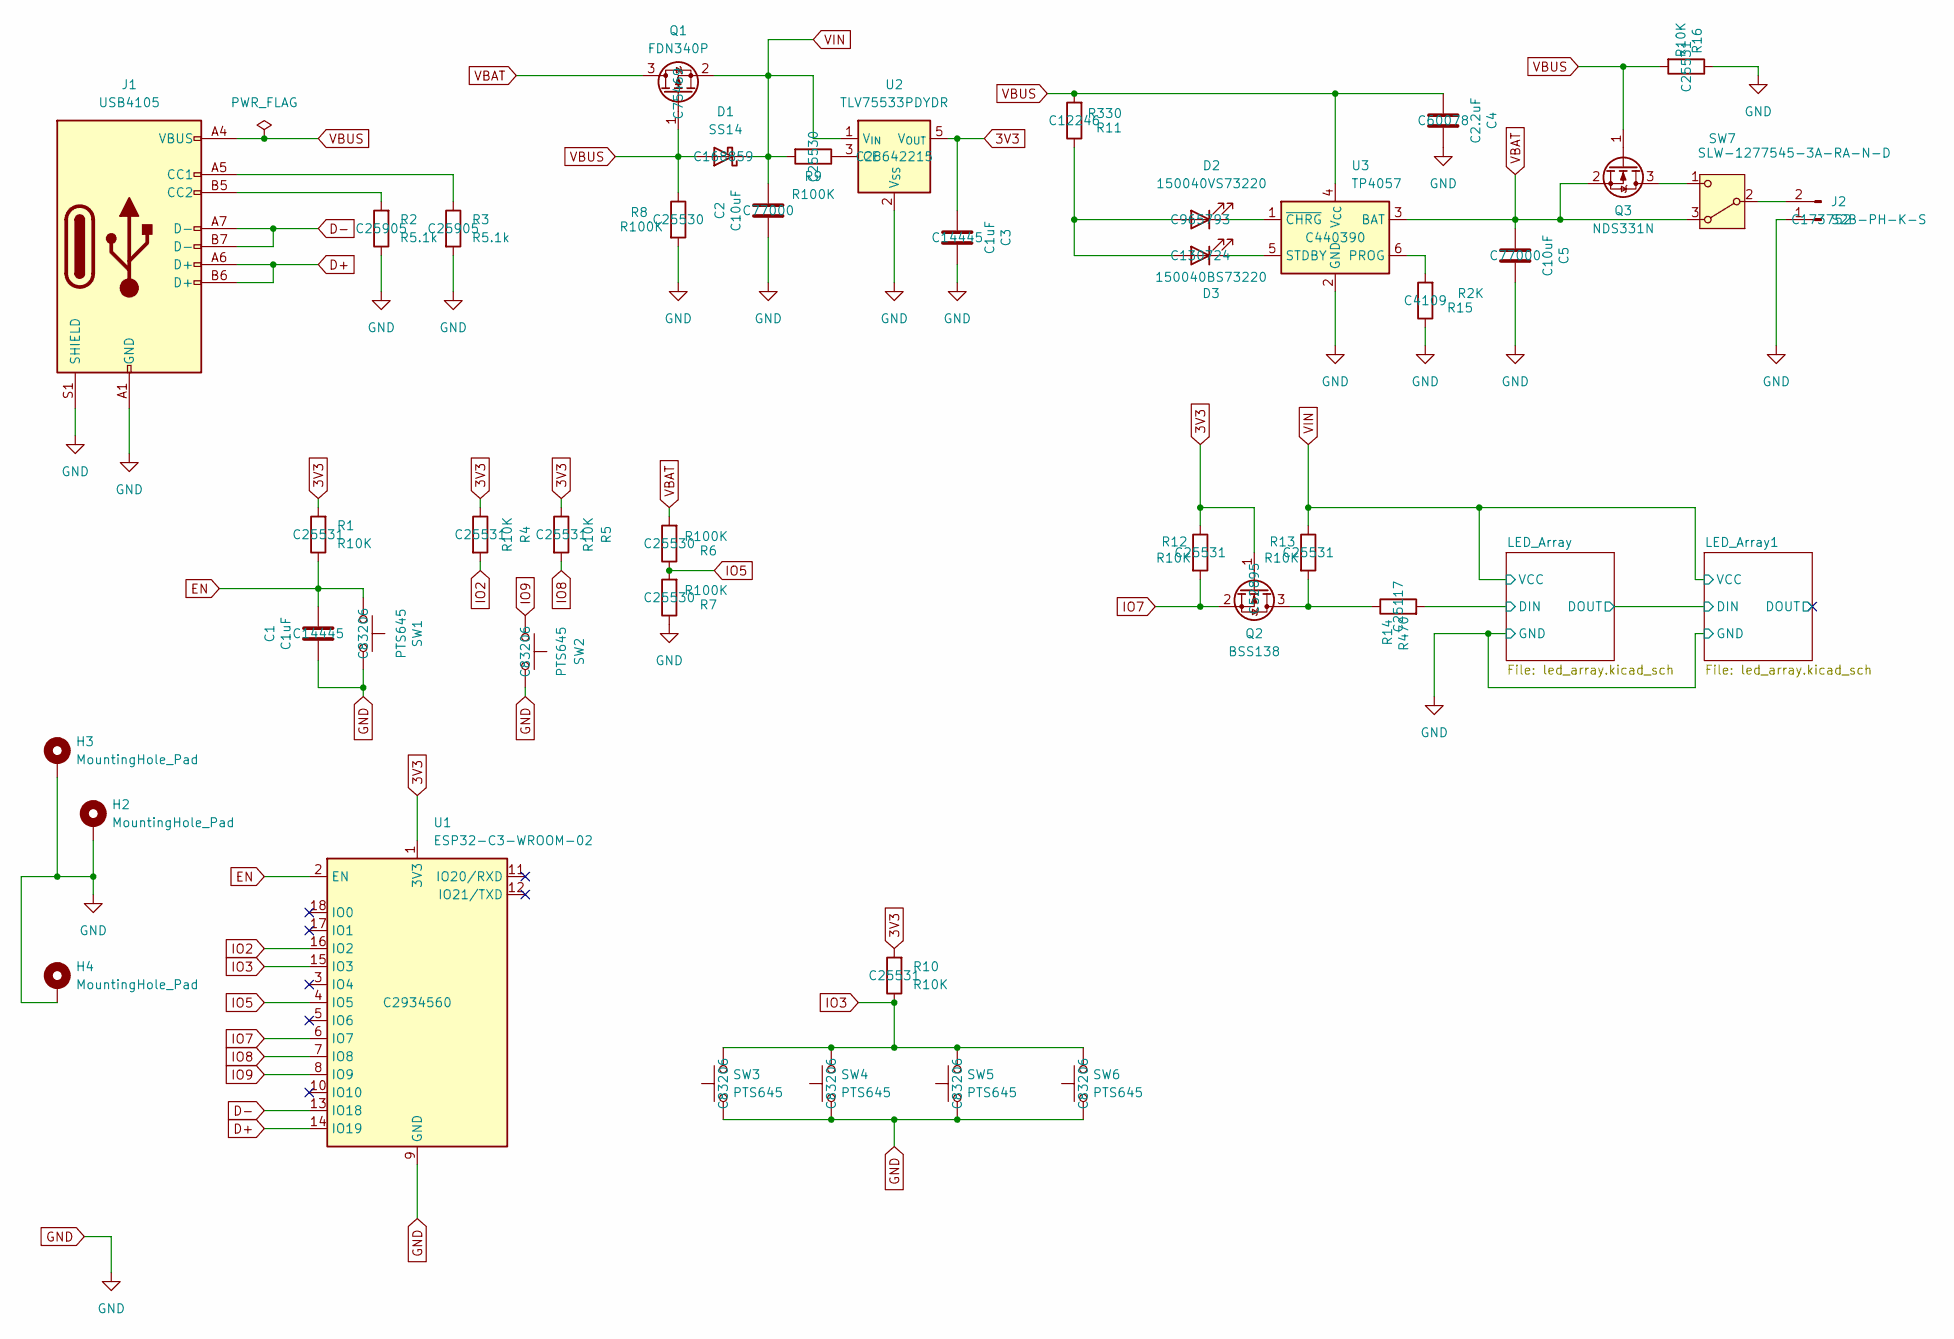
[picture p25: schematic PCB Board.kicad_sch]

Parts:
C1, C3: C1uF; C_0402_1005Metric; LCSC C14445
C2, C5: C10uF; C_0402_1005Metric; LCSC C77000
C4: C2.2uF; C_0402_1005Metric; LCSC C60078
D1: SS14; D_SMA; LCSC C168859
D2: 150040VS73220; LED_0402_1005Metric; LCSC C965793
D3: 150040BS73220; LED_0402_1005Metric; LCSC C130724
H2, H3, H4: MountingHole_Pad; MountingHole_3.2mm_M3_DIN965_Pad_TopBottom
J1: USB4105; USB_C_Receptacle_GCT_USB4105-xx-A_16P_TopMnt_Horizontal
J2: S2B-PH-K-S; JST_PH_S2B-PH-K_1x02_P2.00mm_Horizontal; LCSC C173752
Q1: FDN340P; SOT-23; LCSC C75469
Q2: BSS138; SOT-23; LCSC C52895
Q3: NDS331N; SOT-23
R1, R4, R5, R10, R12, R13, R16: R10K; R_0402_1005Metric; LCSC C25531
R2, R3: R5.1k; R_0402_1005Metric; LCSC C25905
R6, R7, R8, R9: R100K; R_0402_1005Metric; LCSC C25530
R11: R330; R_0402_1005Metric; LCSC C12246
R14: R470; R_0402_1005Metric; LCSC C25117
R15: R2K; R_0402_1005Metric; LCSC C4109
SW1, SW2, SW3, SW4, SW5, SW6: PTS645; SW_SPST_PTS645; LCSC C83206
SW7: SLW-1277545-3A-RA-N-D; SW_Slide_SPDT_Angled_CK_OS102011MA1Q; LCSC C431547
U1: ESP32-C3-WROOM-02; LCSC C2934560
U2: TLV75533PDYDR; SOT-23-5; LCSC C28642215
U3: TP4057; TSOT-23-6; LCSC C440390

Connections:
3V3: C3.1, Q2.1 (G), R1.2, R4.1, R5.1, R10.2, R12.1, U1.1 (3V3), U2.5 (V_{OUT})
/LED_Array/DIN: R14.2; also elsewhere on the board
D+: J1.A6 (D+), J1.B6 (D+), U1.14 (IO19)
D-: J1.A7 (D-), J1.B7 (D-), U1.13 (IO18)
EN: C1.2, R1.1, SW1.1, U1.2 (EN)
GND: C1.1, C2.1, C3.2, C4.2, C5.2, H2.1, H3.1, H4.1, J1.A1 (GND), J1.A12 (GND), J1.B1 (GND), J1.B12 (GND), J1.S1 (SHIELD), J2.1, R2.1, R3.2, R7.1, R8.2, R15.1, R16.1, SW1.2, SW2.1, SW3.1, SW4.1, SW5.1, SW6.1, U1.9 (GND), U1.19 (GND), U2.2 (V_{SS}), U3.2 (GND); also elsewhere on the board
IO2: R4.2, U1.16 (IO2)
IO3: R10.1, SW3.2, SW4.2, SW5.2, SW6.2, U1.15 (IO3)
IO5: R6.1, R7.2, U1.4 (IO5)
IO7: Q2.2 (S), R12.2, U1.6 (IO7)
IO8: R5.2, U1.7 (IO8)
IO9: SW2.2, U1.8 (IO9)
unnamed: D2.2 (A), D3.2 (A), R11.1
unnamed: D2.1 (K), U3.1 (~CHRG)
unnamed: D3.1 (K), U3.5 (STDBY)
unnamed: J1.A5 (CC1), R3.1
unnamed: J1.B5 (CC2), R2.2
unnamed: J2.2, SW7.2 (B)
unnamed: Q2.3 (D), R13.2, R14.1
unnamed: Q3.3 (D), SW7.1 (C)
unnamed: R9.1, U2.3 (CE)
unnamed: R15.2, U3.6 (PROG)
VBAT: C5.1, Q1.3 (D), Q3.2 (S), R6.2, SW7.3 (A), U3.3 (BAT)
VBUS: C4.1, D1.2 (A), J1.A4 (VBUS), J1.A9 (VBUS), J1.B4 (VBUS), J1.B9 (VBUS), Q1.1 (G), Q3.1 (G), R8.1, R11.2, R16.2, U3.4 (V_{CC})
VIN: C2.2, D1.1 (K), Q1.2 (S), R9.2, R13.1, U2.1 (V_{IN}); also elsewhere on the board

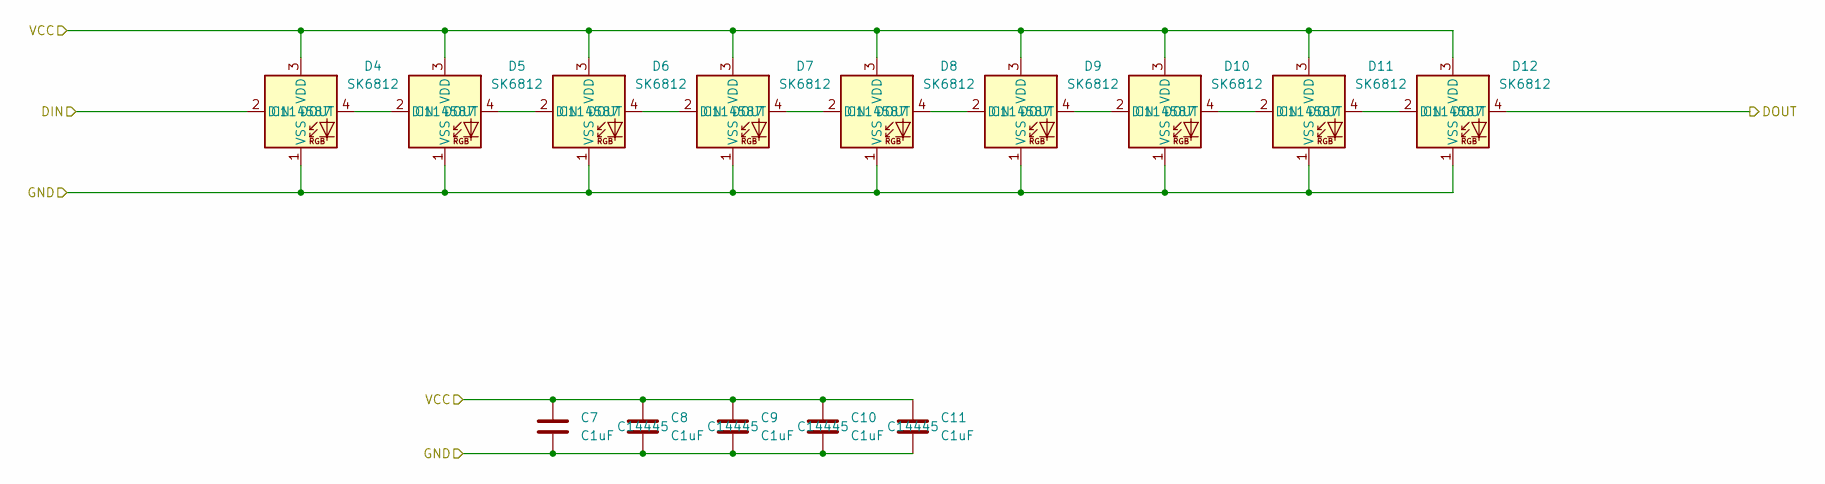
[picture p26: schematic led_array.kicad_sch]

Parts:
C7, C8, C9, C10, C11: C1uF; C_0402_1005Metric; LCSC C14445
D4, D5, D6, D7, D8, D9, D10, D11, D12: SK6812; LED_SK6812_PLCC4_5.0x5.0mm_P3.2mm; LCSC C114587

Connections:
/LED_Array/DIN: D4.2 (DIN); also elsewhere on the board
/LED_Array/DOUT: D12.4 (DOUT); also elsewhere on the board
GND: C7.2, C8.2, C9.2, C10.2, C11.2, D4.1 (VSS), D5.1 (VSS), D6.1 (VSS), D7.1 (VSS), D8.1 (VSS), D9.1 (VSS), D10.1 (VSS), D11.1 (VSS), D12.1 (VSS); also elsewhere on the board
unnamed: D4.4 (DOUT), D5.2 (DIN)
unnamed: D5.4 (DOUT), D6.2 (DIN)
unnamed: D6.4 (DOUT), D7.2 (DIN)
unnamed: D7.4 (DOUT), D8.2 (DIN)
unnamed: D8.4 (DOUT), D9.2 (DIN)
unnamed: D9.4 (DOUT), D10.2 (DIN)
unnamed: D10.4 (DOUT), D11.2 (DIN)
unnamed: D11.4 (DOUT), D12.2 (DIN)
VIN: C7.1, C8.1, C9.1, C10.1, C11.1, D4.3 (VDD), D5.3 (VDD), D6.3 (VDD), D7.3 (VDD), D8.3 (VDD), D9.3 (VDD), D10.3 (VDD), D11.3 (VDD), D12.3 (VDD); also elsewhere on the board

Parts of its further copies:
C13, C14, C15, C16, C17: C1uF; C_0402_1005Metric; LCSC C14445
D13, D14, D15, D16, D17, D18, D19, D20, D21: SK6812; LED_SK6812_PLCC4_5.0x5.0mm_P3.2mm; LCSC C114587

Connections of its further copies:
/LED_Array1/DOUT: D21.4 (DOUT)
/LED_Array/DOUT: D13.2 (DIN); also elsewhere on the board
GND: C13.2, C14.2, C15.2, C16.2, C17.2, D13.1 (VSS), D14.1 (VSS), D15.1 (VSS), D16.1 (VSS), D17.1 (VSS), D18.1 (VSS), D19.1 (VSS), D20.1 (VSS), D21.1 (VSS); also elsewhere on the board
unnamed: D13.4 (DOUT), D14.2 (DIN)
unnamed: D14.4 (DOUT), D15.2 (DIN)
unnamed: D15.4 (DOUT), D16.2 (DIN)
unnamed: D16.4 (DOUT), D17.2 (DIN)
unnamed: D17.4 (DOUT), D18.2 (DIN)
unnamed: D18.4 (DOUT), D19.2 (DIN)
unnamed: D19.4 (DOUT), D20.2 (DIN)
unnamed: D20.4 (DOUT), D21.2 (DIN)
VIN: C13.1, C14.1, C15.1, C16.1, C17.1, D13.3 (VDD), D14.3 (VDD), D15.3 (VDD), D16.3 (VDD), D17.3 (VDD), D18.3 (VDD), D19.3 (VDD), D20.3 (VDD), D21.3 (VDD); also elsewhere on the board

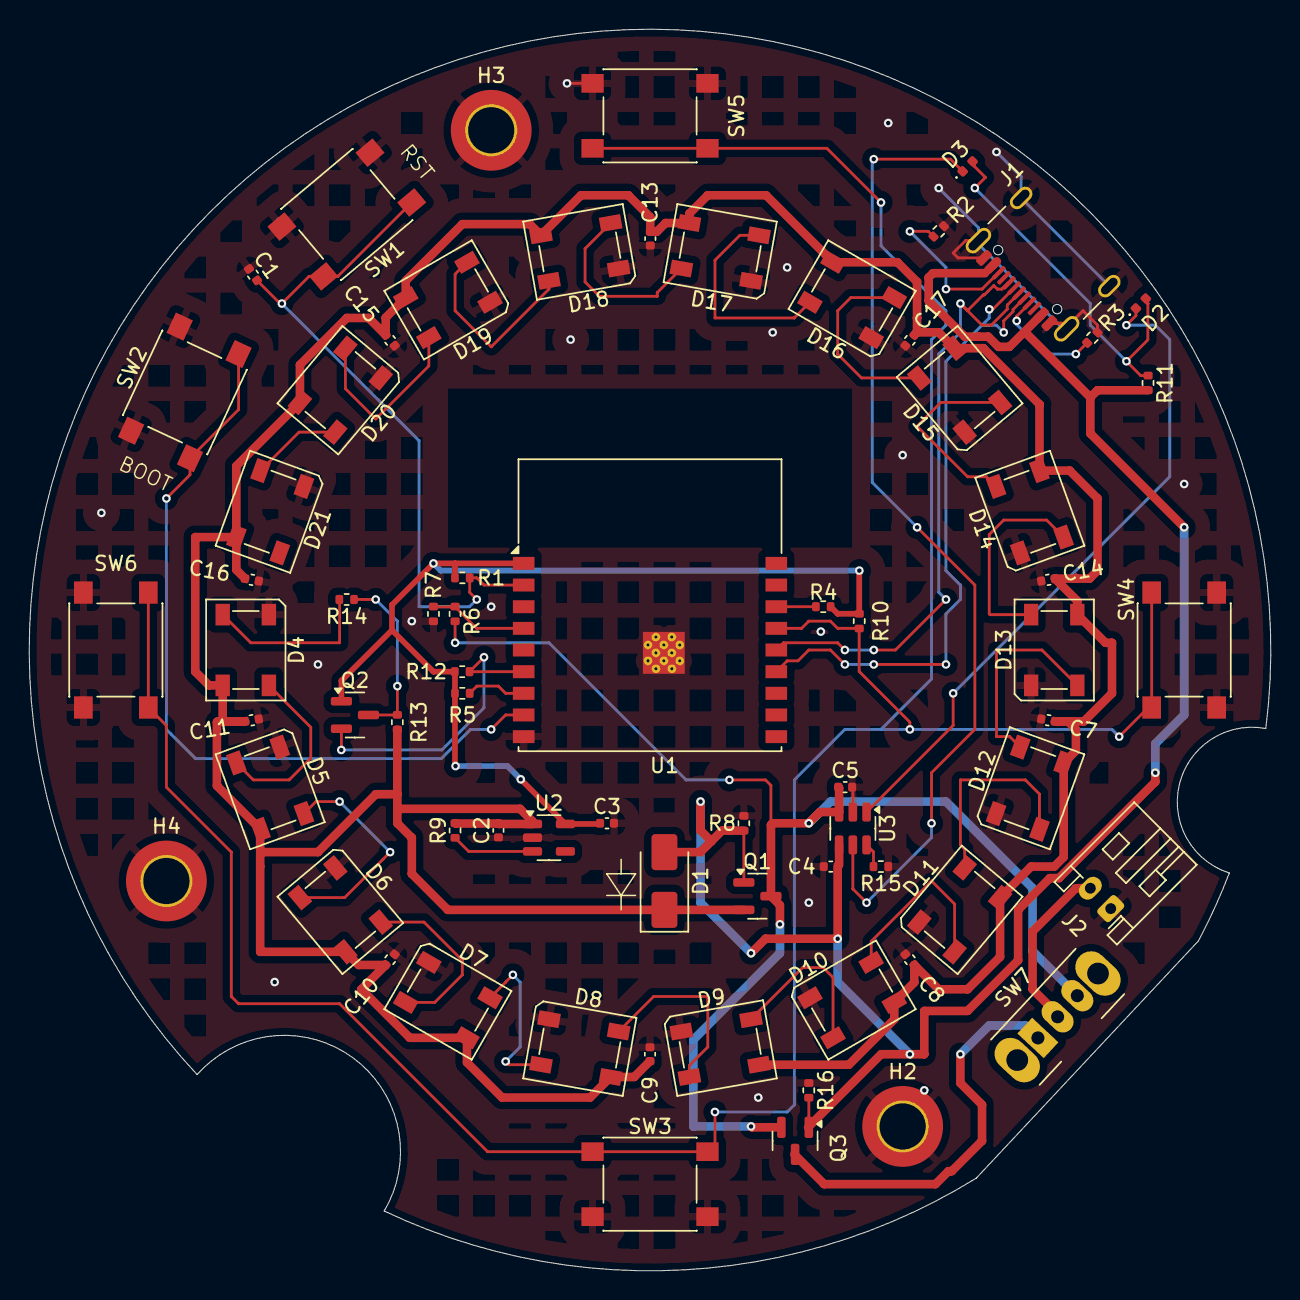
[picture p27: board PCB Board.kicad_pcb from above]

Board: 2 copper layers, 86.0 x 86.0 mm, 70 parts (0 on the bottom side), 42 nets.
