RunningJoke/reactionButton/firmware/src/LEDManager/LEDManager.h

#pragma once

#include <Arduino.h>
#include <Adafruit_NeoPixel.h>
#include <esp_timer.h>
#include <freertos/FreeRTOS.h>
#include <freertos/semphr.h>
#include "ColorSet/ColorSet.h"
#include "Link/Protocol.h"
#include "LEDManager/SystemPattern.h"
#include "_Definitions.h"

#define LED_PIN 7
#define NEOPIXEL_SIZE 18

struct LEDPaletteID {
    uint64_t bitmask;

    LEDPaletteID(int palette[18]) {
        this->bitmask = 0;
        for(int i = 0; i < NEOPIXEL_SIZE; i++) {
            this->setPaletteID(i,palette[i]);
        }
    }

    void setPaletteID(int led, uint8_t paletteId) {
        this->bitmask &= ~(0x7ULL << (3*led));           // Clear the 3 bits
        this->bitmask |= (uint64_t(paletteId & 0x7) << (3*led)); // Set new value
    };
    uint8_t getPaletteID(int i) {
        return (this->bitmask >> (3*i)) & 0x7;
    }
};

class LEDAnimation {
    public:
        virtual void animate(uint64_t timestamp) = 0;
};

struct LEDPattern {
    ColorSet* palette[8];
    LEDPaletteID* ids;
    LEDAnimation* animation;
};

/**
 * The LED ring.
 *
 * Static output: setLEDColors(...) / turnOff(). Every static call stops a running effect.
 *
 * Effect player: one effect at a time (Protocol::EffectDesc, link-protocol.md §2.1).
 * An effect is a pure function of the time since its start, so pods that were given the
 * same start time on the synchronised clock show the same frame, and a late start only
 * skips ahead. service() (once per loop pass, RoleManager::run) draws a new frame only when
 * it differs from the last one, at most every MIN_FRAME_US. When no effect animates,
 * service() returns at once and isAnimating() is false (light sleep allowed, #21).
 *
 * A start time in the future is armed on an esp_timer, so the first frame is drawn at the start
 * time and not at the next loop pass (up to one loop gap late, see docs/firmware/timing.md).
 * The timer runs in the esp_timer task; the output is guarded by a mutex (outputMutex).
 *
 * All output is scaled by the brightness cap (LED_BRIGHTNESS_CAP in _Definitions.h, #21). Every
 * write to the driver goes through present(), which calls show() only when the buffer differs from
 * the last frame sent. Static calls therefore cost no LED time when nothing changes.
 *
 * System patterns (fw >= 2.15, #82): the firmware's own signals (boot, search, joined, ...) are played the
 * same way with playPattern (SystemPattern.h). They share the effect player: a pattern ends an effect and the
 * other way round, and every static call stops both. Pattern levels are perceived brightness (gamma 2).
 */
class LEDManager {
    protected:
        ColorSet* pOffConfiguration;
        ColorSet* pCurrentColorConfiguration;

        uint8_t neoPixelPin;
        Adafruit_NeoPixel* pixelManager;

        static LEDManager* manager;
        LEDManager(uint8_t neoPixelPin);
    public:
        static LEDManager* getManager();
        void setLEDColors(ColorSet* pNewColorSet);
        void setLEDColors(uint8_t colorId);
        void setLEDColors(uint8_t index, ColorSet* pNewColorSet);
        void setLEDColors(LEDPattern* pattern);
        // Static: `count` LEDs from LED `first` (wrapping) in colour `colorId`, the rest in `restId`
        void setSegment(uint8_t first, uint8_t count, uint8_t colorId, uint8_t restId);
        void turnOff();

        // ------------------------------------------------------------ effect player

        // Plays an effect. startUs = local esp_timer time (µs); 0 = now. On the central the
        // network time (IPodNetwork::nowUs) is the local time; a peripheral converts with
        // ClockSync::toLocal. If the start time has come, the first frame is shown before
        // this returns (reaction times are measured from it). Before a later start time the
        // LEDs stay as they are. EffectId::NONE stops and switches off.
        // ledMask: bit i = LED i takes part (the effect is computed for the whole ring, the
        // other LEDs keep their colour). Used by the effect block's "leds" on the central.
        // Returns false (nothing changed) for an unknown effect id.
        bool playEffect(const Protocol::EffectDesc& effect, int64_t startUs = 0, uint32_t ledMask = ALL_LEDS);

        // Plays a system pattern (SystemPattern.h), firmware only. startUs as for playEffect. The ring as it is
        // now is kept as the snapshot that SELECT / SELECT_CANCEL draw over.
        void playPattern(SystemPattern::Id id, const SystemPattern::Args& args = SystemPattern::Args(), int64_t startUs = 0);
        // Bar of a playing UPDATE pattern (0 ... 100); other patterns are not changed. Call it between a request and
        // its response: it draws the frame (at most every UPDATE_FRAME_US, about 0.6 ms) while no bytes arrive
        void setPatternPercent(uint8_t percent);

        // Stops the effect; the LEDs keep the last frame
        void stopEffect() { this->effectState = EffectState::IDLE; }

        // Advances the effect. Call once per loop pass.
        void service() {
            if(this->effectState == EffectState::RUNNING) {
                this->serviceEffect();
            }
        }

        // An effect still changes the LEDs (or waits for its start). False = light sleep allowed.
        bool isAnimating() const { return this->effectState == EffectState::RUNNING; }

        // Id of the last effect played (NONE after a static call or stop). A finished or static
        // effect keeps its id, isAnimating() tells whether it still moves.
        Protocol::EffectId currentEffect() const {
            return this->effectState == EffectState::IDLE || this->mode != Mode::EFFECT
                 ? Protocol::EffectId::NONE : this->effect.effect;
        }

        // Id of the last system pattern played (NONE after a static call, stop or effect). A finished pattern
        // keeps its id, isAnimating() tells whether it still moves.
        SystemPattern::Id currentPattern() const {
            return this->effectState == EffectState::IDLE || this->mode != Mode::PATTERN
                 ? SystemPattern::Id::NONE : this->pattern;
        }

        // Local start time of the current effect (µs)
        int64_t effectStartUs() const { return this->effectStart; }

        // Upper limit for all output (battery / power, #21), LED_BRIGHTNESS_CAP by default.
        // Applies from the next frame / call.
        void setBrightnessCap(uint8_t cap) { this->cap = cap; }
        uint8_t brightnessCap() const { return this->cap; }

        // RGB of a link colour index (0 red … 6 white, 255 off). False for unknown indices.
        static bool colorOf(uint8_t colorId, ColorSet& out);

        // Effect names as used in JSON ("fill", "colorShift", …); nullptr / NONE if unknown
        static const char* effectName(Protocol::EffectId id);
        static Protocol::EffectId effectFromName(const char* name);

        static const uint32_t ALL_LEDS = (1UL << NEOPIXEL_SIZE) - 1;
        static const int64_t MIN_FRAME_US = 16000;     // at most ~60 frames per second
        static const int64_t UPDATE_FRAME_US = 50000;  // the update bar: at most 20 frames per second (#125, #122)
        static const int64_t UPDATE_STREAM_US = 500000;  // no chunk for this long: service() draws the bar again

    private:
        enum class EffectState : uint8_t { IDLE, RUNNING, HOLD };    // HOLD: finished or static, last frame stays
        enum class Mode : uint8_t { EFFECT, PATTERN };                // what the player plays

        uint32_t scaled(const ColorSet& color, uint8_t level) const;
        // show() if the buffer changed since the last show()
        void present();
        void serviceEffect(bool updateFrame = false);
        void renderEffect(int64_t nowUs);
        // pattern frame into next[]; true when the pattern has ended
        bool renderPattern(uint32_t elapsedMs, uint32_t* next);
        // length of what plays (ms), 0 = endless or still
        uint32_t playingDurationMs() const;
        // starts the player for the current effect / pattern (mutex held)
        void startPlayer(int64_t startUs);
        static void onStartTimer(void* arg);

        SemaphoreHandle_t outputMutex = nullptr;    // recursive: the LEDs are written by the loop and the timer task
        esp_timer_handle_t startTimer = nullptr;    // draws the first frame of an effect at its start time

        Protocol::EffectDesc effect = {Protocol::EffectId::NONE, 0, 0, 0, 0, 0, 0, 0};
        Mode mode = Mode::EFFECT;
        SystemPattern::Id pattern = SystemPattern::Id::NONE;
        SystemPattern::Args patternArgs;
        uint32_t snapshot[NEOPIXEL_SIZE];           // the ring when the pattern started (SELECT draws over it)
        EffectState effectState = EffectState::IDLE;
        int64_t effectStart = 0;
        int64_t lastFrameUs = 0;
        int64_t updateStreamUs = -UPDATE_STREAM_US;   // last chunk of an update (setPatternPercent)
        uint32_t ledMask = ALL_LEDS;
        uint32_t frame[NEOPIXEL_SIZE];
        uint32_t shown[NEOPIXEL_SIZE];              // what the driver was given last (present())
        uint8_t cap = LED_BRIGHTNESS_CAP;
};
