RunningJoke/reactionButton/firmware/src/Roles/Peripheral/PeripheralRole.cpp

#include "PeripheralRole.h"
#include "_Definitions.h"
#include "LEDManager/LEDManager.h"
#include "Input/Button.h"
#include "Settings/Settings.h"
#include "Config/ConfigApi.h"
#include "LEDManager/EffectJson.h"
#include "LEDManager/SystemPattern.h"
#include "LEDManager/Identity.h"
#include "Battery/Battery.h"
#include <WiFi.h>

using namespace Protocol;

static const char* TAG = "PERIPHERAL";

PeripheralRole::PeripheralRole() {
    this->setId = Settings::getSetId();
    this->sync.setSetId(this->setId);

    if(!this->link.begin(ESPNOW_CHANNEL)) {
        ESP_LOGE(TAG, "radio start failed");
    }
    this->becomeUnclaimed();
    ESP_LOGI(TAG, "peripheral started, set %08x", this->setId);
}

void PeripheralRole::becomeUnclaimed() {
    this->state = State::UNCLAIMED;
    this->clock.clear();
    this->pairResetDone = false;
    this->identifyWanted = false;
    this->identityShown = IdentityShow::NONE;
    this->showUnclaimed();
}

// Searching for a central: the SEARCH pattern, not synced to anything
void PeripheralRole::showUnclaimed() {
    LEDManager::getManager()->playPattern(SystemPattern::Id::SEARCH);
}

void PeripheralRole::run() {
    Button& button = Button::get();
    button.update();
    this->link.service();

    RxFrame frame;
    while(this->link.receive(frame)) {
        this->handleFrame(frame);
    }

    int64_t now = esp_timer_get_time();

    if(this->state == State::UNCLAIMED) {
        if(now - this->lastHelloUs >= HELLO_INTERVAL_US) {
            this->lastHelloUs = now;
            Hello hello;
            fillHeader(hello.header, MsgType::HELLO, this->setId);
            hello.fwMajor = FW_VERSION_MAJOR;
            hello.fwMinor = FW_VERSION_MINOR;
            this->link.broadcast(&hello, sizeof(hello));
        }

        // hold the button 3 s while unclaimed: forget the set, any central may claim the pod
        if(button.isDown() && !this->pairResetDone && now - button.lastPressTimeUs() >= PAIR_RESET_HOLD_US) {
            this->pairResetDone = true;
            this->setId = 0;
            Settings::setSetId(0);
            ESP_LOGI(TAG, "pairing cleared");
            LEDManager::getManager()->setLEDColors(WHITE);
            delay(500);
            this->showUnclaimed();
        }
        return;
    }

    // claimed: heartbeat, central supervision, store sync
    this->sync.service();
    if(now - this->lastPingUs >= PING_INTERVAL_US) {
        this->lastPingUs = now;
        this->sendPing();
    }
    if(now - this->lastPongUs > CENTRAL_TIMEOUT_US) {
        ESP_LOGW(TAG, "central lost");
        this->becomeUnclaimed();
        return;
    }

    // idle ring: identity (#20) and the low-battery warning (#19). Any activation or effect takes the
    // ring, so programs never see either during a game.
    if(this->state == State::READY) {
        this->updateIdentity(now);
    }

    switch(this->state) {
        case State::SCHEDULED:
            if(now >= this->scheduledLocalUs) {
                this->activate();
            }
            break;

        case State::ACTIVE:
            if(this->mode == PodMode::TOGGLE) {
                this->runToggle();
                break;
            }
            if(button.pressCount() != this->pressCountAtActivation) {
                int64_t reactionUs = button.lastPressTimeUs() - this->activatedUs;
                LEDManager::getManager()->setLEDColors(this->colorAfter);

                Pressed pressed;
                fillHeader(pressed.header, MsgType::PRESSED, this->setId);
                pressed.podId = this->podId;
                pressed.cmdSeq = this->cmdSeq;
                pressed.result = this->mode == PodMode::AVOID ? PressResult::AVOID_HIT : PressResult::HIT;
                pressed.reactionUs = (int32_t)reactionUs;
                this->link.send(this->centralMac, &pressed, offsetof(Pressed, owner), 8, -1, true);

                this->state = State::DONE;
            }
            break;

        case State::HOLDING:
            this->runHold();
            break;

        default:
            break;
    }
}

// Identity display of a ready pod (see the class comment). The pattern is started once per change of the
// wanted display, not on every pass; an activation or a game takes the ring first (handleArm clears
// identityShown).
void PeripheralRole::updateIdentity(int64_t now) {
    if(now < this->identityBlockedUntilUs) {
        return;     // the central's effect (blink) owns the ring
    }
    IdentityShow wanted = Battery::isLow() ? IdentityShow::LOW_BATTERY
                        : now < this->claimJoinedUntilUs || this->identifyWanted ? IdentityShow::JOINED
                        : IdentityShow::NONE;
    if(wanted == this->identityShown) {
        return;
    }
    this->identityShown = wanted;

    LEDManager* leds = LEDManager::getManager();
    switch(wanted) {
        case IdentityShow::NONE:
            leds->turnOff();
            break;
        case IdentityShow::JOINED:
        {
            SystemPattern::Args args;
            args.podId = this->podId;
            leds->playPattern(SystemPattern::Id::JOINED, args);
            break;
        }
        case IdentityShow::LOW_BATTERY:
            leds->playPattern(SystemPattern::Id::LOW_BATTERY);     // replaces the identity (#19)
            break;
    }
}

// TOGGLE: a press flips the owner (locally, no round trip) unless the cooldown has not passed since the
// last flip. PRESSED carries the absolute owner, so a lost frame is corrected by the next one.
void PeripheralRole::runToggle() {
    Button& button = Button::get();
    if(button.pressCount() == this->pressCountAtActivation) {
        return;
    }
    this->pressCountAtActivation = button.pressCount();     // several presses in one pass count once

    int64_t pressUs = button.lastPressTimeUs();
    if(this->toggleFlips > 0 && pressUs - this->toggleLastFlipUs < this->toggleCooldownUs) {
        return;
    }
    this->toggleLastFlipUs = pressUs;
    this->toggleFlips++;
    this->toggleOwner = this->toggleOwner == OWNER_A ? OWNER_B : OWNER_A;
    this->showToggleOwner();

    Pressed pressed;
    fillHeader(pressed.header, MsgType::PRESSED, this->setId);
    pressed.podId = this->podId;
    pressed.cmdSeq = this->cmdSeq;
    pressed.result = PressResult::HIT;
    pressed.reactionUs = (int32_t)(pressUs - this->activatedUs);
    pressed.owner = this->toggleOwner;
    pressed.flipCount = this->toggleFlips;
    this->link.send(this->centralMac, &pressed, sizeof(pressed), 8, -1, true);
}

// The ring in the colour of the owner. A countdown keeps running across flips: it is timed from the
// activation, so the effect with the new colour joins at the right point.
void PeripheralRole::showToggleOwner() {
    uint8_t color = this->toggleOwner == OWNER_A ? this->colorActive
                  : this->toggleOwner == OWNER_B ? this->colorAfter : (uint8_t)Color::OFF;
    LEDManager* leds = LEDManager::getManager();
    if(this->hasWaitingEffect) {
        EffectDesc effect = this->waitingEffect;
        effect.color = color;
        if(this->toggleEffectStartUs == 0) {
            this->toggleEffectStartUs = this->waitingEffectStartUs != 0 ? this->waitingEffectStartUs : esp_timer_get_time();
        }
        if(leds->playEffect(effect, this->toggleEffectStartUs)) {
            return;
        }
    }
    leds->setLEDColors(color);
}

// CHARGE / RELEASE: report the hold start and the end of the hold
void PeripheralRole::runHold() {
    HoldSession::Event event;
    while(this->hold.poll(esp_timer_get_time(), event)) {
        if(event.kind == HoldSession::Event::Kind::HOLD_STARTED) {
            Pressed pressed;
            fillHeader(pressed.header, MsgType::PRESSED, this->setId);
            pressed.podId = this->podId;
            pressed.cmdSeq = this->cmdSeq;
            pressed.result = PressResult::HIT;
            pressed.reactionUs = event.reactionUs;
            this->link.send(this->centralMac, &pressed, offsetof(Pressed, owner), 8, -1, true);
            continue;
        }

        Released released;
        fillHeader(released.header, MsgType::RELEASED, this->setId);
        released.podId = this->podId;
        released.cmdSeq = this->cmdSeq;
        released.flags = event.flags;
        released.heldMs = event.heldMs;
        released.reactionUs = event.reactionUs;
        released.chargeMs = event.chargeMs;
        this->link.send(this->centralMac, &released, sizeof(released), 8, -1, true);
        this->state = State::DONE;
        return;
    }
}

void PeripheralRole::sendPing() {
    Ping ping;
    fillHeader(ping.header, MsgType::PING, this->setId);
    ping.t1 = 0;    // stamped by the link when the frame goes to the radio
    ping.store = StoreSync::localState();
    ping.batteryMv = Battery::milliVolts();
    this->link.send(this->centralMac, &ping, sizeof(ping), 0, (int8_t)offsetof(Ping, t1));
}

void PeripheralRole::handleFrame(const RxFrame& frame) {
    const Header* header = reinterpret_cast<const Header*>(frame.data);
    if(frame.len < frameSize(header->type)) {
        return;
    }

    if(header->type == MsgType::CLAIM) {
        this->handleClaim(frame);
        return;
    }

    // everything else only from our central
    if(this->state == State::UNCLAIMED || !EspNowLink::sameMac(frame.mac, this->centralMac)
        || header->setId != this->setId) {
        return;
    }

    switch(header->type) {
        case MsgType::PONG:
        {
            const Pong* pong = reinterpret_cast<const Pong*>(frame.data);
            this->clock.addSample(pong->t1, pong->t2, pong->t3, frame.rxUs);
            this->lastPongUs = frame.rxUs;
            this->identifyWanted = (pong->flags & PONG_FLAG_IDENTIFY) != 0;     // revision 4; older centrals never set it
            this->sync.peerState(frame.mac, pong->store, (pong->flags & PONG_FLAG_SYNC_ALLOWED) != 0);
            break;
        }
        case MsgType::ARM:
            this->handleArm(frame);
            break;

        case MsgType::EFFECT:
            this->handleEffect(*reinterpret_cast<const Effect*>(frame.data));
            break;

        case MsgType::SYNC_READ_REQ:
        case MsgType::SYNC_READ_RESP:
            this->sync.handleFrame(frame);
            break;

        case MsgType::RESET:
            this->hold.end();
            this->state = State::READY;
            this->identityBlockedUntilUs = 0;
            this->identityShown = IdentityShow::NONE;
            LEDManager::getManager()->turnOff();
            break;

        default:
            break;
    }
}

void PeripheralRole::handleClaim(const RxFrame& frame) {
    const Claim* claim = reinterpret_cast<const Claim*>(frame.data);

    bool fromOurCentral = this->state != State::UNCLAIMED && EspNowLink::sameMac(frame.mac, this->centralMac);
    if(this->state != State::UNCLAIMED && !fromOurCentral) {
        return;     // already taken by another central
    }
    if(this->setId != 0 && claim->header.setId != this->setId) {
        return;     // paired with another set
    }

    if(this->setId != claim->header.setId) {
        this->setId = claim->header.setId;
        this->sync.setSetId(this->setId);
        Settings::setSetId(this->setId);
        ESP_LOGI(TAG, "paired with set %08x", this->setId);
    }

    memcpy(this->centralMac, frame.mac, 6);
    this->podId = claim->podId;

    ClaimAck ack;
    fillHeader(ack.header, MsgType::CLAIM_ACK, this->setId);
    ack.podId = this->podId;
    ack.linkFeatures = LINK_FEATURE_EFFECTS | LINK_FEATURE_HOLD | LINK_FEATURE_TOGGLE | LINK_FEATURE_BATTERY;
    this->link.send(this->centralMac, &ack, sizeof(ack), 3);

    this->claimJoinedUntilUs = esp_timer_get_time() + CLAIM_JOINED_US;
    this->identityBlockedUntilUs = 0;
    this->identityShown = IdentityShow::NONE;

    if(this->state == State::UNCLAIMED) {
        this->state = State::READY;
        this->lastPongUs = esp_timer_get_time();    // grace period until the first PONG
        this->lastPingUs = 0;                       // ping right away to start the clock sync
        LEDManager::getManager()->turnOff();
        ESP_LOGI(TAG, "claimed as pod %u", this->podId);
    }
}

int64_t PeripheralRole::localStartUs(int64_t centralUs) const {
    if(centralUs == 0 || !this->clock.isSynced()) {
        return 0;   // now
    }
    int64_t local = this->clock.toLocal(centralUs);
    return local != 0 ? local : 1;
}

void PeripheralRole::handleArm(const RxFrame& frame) {
    const Arm& arm = *reinterpret_cast<const Arm*>(frame.data);

    // CHARGE / RELEASE carry hold parameters (appended after the waiting effect, firmware >= 2.9).
    // A shorter ARM is ignored: the pod would not know what to measure.
    bool holdMode = arm.mode == PodMode::CHARGE || arm.mode == PodMode::RELEASE;
    if(holdMode && frame.len < offsetof(Arm, toggle)) {
        ESP_LOGW(TAG, "hold ARM without parameters ignored");
        return;
    }
    // TOGGLE carries its parameters after the (zeroed) hold parameters (firmware >= 2.10)
    if(arm.mode == PodMode::TOGGLE && frame.len < sizeof(Arm)) {
        ESP_LOGW(TAG, "toggle ARM without parameters ignored");
        return;
    }

    this->identityShown = IdentityShow::NONE;      // the activation takes the ring
    this->identityBlockedUntilUs = 0;
    this->cmdSeq = arm.cmdSeq;
    this->mode = arm.mode;
    this->colorActive = arm.colorActive;
    this->colorAfter = arm.colorAfter;
    this->hold.end();       // an earlier hold activation ends with the new ARM

    // optional waiting effect (appended field, firmware >= 2.8). It is timed from the start
    // time, so a late ARM joins the animation of the other pods instead of restarting it.
    this->hasWaitingEffect = frame.len >= offsetof(Arm, hold) && arm.waiting.effect != EffectId::NONE;
    if(this->hasWaitingEffect) {
        this->waitingEffect = arm.waiting;
        this->waitingEffectStartUs = this->localStartUs(arm.startAtUs);
    }

    if(holdMode) {
        this->holdCommand = ArmCommand();
        this->holdCommand.mode = arm.mode;
        this->holdCommand.colorActive = arm.colorActive;
        this->holdCommand.colorAfter = arm.colorAfter;
        this->holdCommand.waiting = arm.waiting;
        this->holdCommand.hold = arm.hold;
    }

    if(arm.mode == PodMode::TOGGLE) {
        this->toggleOwner = arm.toggle.startOwner <= OWNER_NONE ? arm.toggle.startOwner : OWNER_NONE;
        this->toggleFlips = 0;
        this->toggleCooldownUs = (int64_t)arm.toggle.cooldownMs * 1000;
        this->toggleLastFlipUs = 0;
        this->toggleEffectStartUs = 0;
    }

    int64_t now = esp_timer_get_time();
    if(arm.startAtUs != 0 && this->clock.isSynced()) {
        this->scheduledLocalUs = this->clock.toLocal(arm.startAtUs);
        if(this->scheduledLocalUs > now) {
            this->state = State::SCHEDULED;
            LEDManager::getManager()->turnOff();
            return;
        }
    }
    // immediate, or the start time has already passed (late delivery)
    this->activate();
}

void PeripheralRole::handleEffect(const Effect& effect) {
    // only the LEDs change; an armed pod stays armed (its next LED change wins)
    int64_t startUs = this->localStartUs(effect.startAtUs);
    if(!LEDManager::getManager()->playEffect(effect.effect, startUs)) {
        ESP_LOGW(TAG, "unknown effect %u ignored", (unsigned)effect.effect.effect);
        return;
    }
    // the identity comes back after the effect (endless: until the next ARM or RESET)
    int64_t start = startUs == 0 ? esp_timer_get_time() : startUs;
    this->identityBlockedUntilUs = effect.effect.durationMs == 0 ? INT64_MAX : start + (int64_t)effect.effect.durationMs * 1000;
    this->identityShown = IdentityShow::NONE;
}

void PeripheralRole::activate() {
    LEDManager* leds = LEDManager::getManager();
    if(this->mode == PodMode::CHARGE || this->mode == PodMode::RELEASE) {
        this->hold.begin(this->holdCommand, Button::get(), *leds);
        this->activatedUs = esp_timer_get_time();
        this->state = State::HOLDING;
        return;
    }
    if(this->mode == PodMode::TOGGLE) {
        this->showToggleOwner();
    } else if(!this->hasWaitingEffect || !leds->playEffect(this->waitingEffect, this->waitingEffectStartUs)) {
        leds->setLEDColors(this->colorActive);
    }
    // measure from the moment the LED data was sent; only presses after this count
    this->activatedUs = esp_timer_get_time();
    this->pressCountAtActivation = Button::get().pressCount();
    this->state = State::ACTIVE;
}

// ---------------------------------------------------------------- configuration API

const char* PeripheralRole::stateName(State state) {
    switch(state) {
        case State::UNCLAIMED: return "UNCLAIMED";
        case State::READY: return "READY";
        case State::SCHEDULED: return "SCHEDULED";
        case State::ACTIVE: return "ACTIVE";
        case State::HOLDING: return "HOLDING";
        case State::DONE: return "DONE";
    }
    return "?";
}

bool PeripheralRole::storeEditable() const {
    return !this->sync.isPulling() && this->state != State::ACTIVE && this->state != State::HOLDING && this->state != State::SCHEDULED;
}

void PeripheralRole::describe(JsonObject status) {
    status["state"] = stateName(this->state);
    status["syncing"] = this->sync.isPulling();
    if(this->state == State::UNCLAIMED) {
        return;
    }

    char mac[18];
    snprintf(mac, sizeof(mac), "%02x:%02x:%02x:%02x:%02x:%02x", this->centralMac[0], this->centralMac[1],
             this->centralMac[2], this->centralMac[3], this->centralMac[4], this->centralMac[5]);
    status["podId"] = this->podId;
    status["central"] = mac;
    status["lastPongMs"] = (uint32_t)((esp_timer_get_time() - this->lastPongUs) / 1000);

    JsonObject clock = status["clock"].to<JsonObject>();
    clock["synced"] = this->clock.isSynced();
    clock["offsetUs"] = this->clock.offset();

    EspNowLink::LinkStats st;
    if(this->link.stats(this->centralMac, st)) {
        JsonObject l = status["link"].to<JsonObject>();
        l["txFrames"] = st.txFrames;
        l["txRetries"] = st.txRetries;
        l["txLost"] = st.txLost;
        l["rxFrames"] = st.rxFrames;
        l["rxDuplicates"] = st.rxDuplicates;
        l["ackUsLast"] = st.lastAckUs;
        l["ackUsAvg"] = st.avgAckUs;
        l["ackUsMax"] = st.maxAckUs;
    }
}

bool PeripheralRole::control(const char* op, JsonObjectConst request, JsonDocument& response) {
    if(strcmp(op, "press") == 0) {
        Button::get().simulatePress();
        response["ok"] = true;
        response["state"] = stateName(this->state);
        return true;
    }
    if(strcmp(op, "effect") == 0) {
        // test op: play an effect on this pod's ring
        if(this->state == State::ACTIVE || this->state == State::HOLDING || this->state == State::SCHEDULED) {
            ConfigApi::setError(response, "busy", String("state is ") + stateName(this->state));
            return true;
        }
        EffectDesc effect;
        String error;
        if(!EffectJson::parse(request, effect, error)) {
            ConfigApi::setError(response, "bad_request", error);
            return true;
        }
        uint32_t delayMs = request["delayMs"] | 0u;
        LEDManager::getManager()->playEffect(effect, delayMs != 0 ? esp_timer_get_time() + (int64_t)delayMs * 1000 : 0);
        response["ok"] = true;
        response["effect"] = LEDManager::effectName(effect.effect);
        return true;
    }
    if(strcmp(op, "pattern") == 0) {
        // test op: play a system pattern on this pod's ring
        if(this->state == State::ACTIVE || this->state == State::HOLDING || this->state == State::SCHEDULED) {
            ConfigApi::setError(response, "busy", String("state is ") + stateName(this->state));
            return true;
        }
        const char* name = request["name"].as<const char*>();
        if(name == nullptr) {
            ConfigApi::setError(response, "bad_request", "'name' missing");
            return true;
        }
        SystemPattern::Id id = SystemPattern::fromName(name);
        if(id == SystemPattern::Id::COUNT_) {
            ConfigApi::setError(response, "bad_request", String("unknown pattern '") + name + "'");
            return true;
        }
        SystemPattern::Args args;
        args.percent = request["percent"] | 255u;
        args.podId = request["podId"] | 0u;
        args.wanted = request["wanted"] | 0u;
        args.found = request["found"] | 0u;
        args.fillMs = request["fillMs"] | 0u;
        args.breathing = request["breathing"] | false;
        LEDManager::getManager()->playPattern(id, args);
        response["ok"] = true;
        response["pattern"] = SystemPattern::name(id);
        response["durationMs"] = SystemPattern::durationMs(id, args);
        return true;
    }
    return false;
}
