RunningJoke/reactionButton/firmware/src/Roles/Central/PodNetwork.h

#pragma once

#include <Arduino.h>
#include <deque>
#include <vector>
#include <ArduinoJson.h>
#include "Link/IPodNetwork.h"
#include "Link/EspNowLink.h"
#include "Store/StoreSync.h"

/**
 * Central side of the pod link.
 *
 * - Claims peripherals that announce themselves with HELLO (one claim at a time, so pod
 *   ids are given out in order without gaps).
 * - A peripheral that rebooted announces itself again; it is re-claimed with its old id.
 * - Answers PINGs (heartbeat + clock sync). A pod without PING for POD_TIMEOUT_US is lost.
 * - The central's esp_timer is the network time base.
 * - Remembers which pods play effects / measure holds (CLAIM_ACK linkFeatures); older pods get no
 *   EFFECT frames, no hold activations and a plain ARM.
 * - Runs the program store sync with the peripherals (StoreSync), only while allowed.
 * - Tells the pods whether they show their identity (PONG_FLAG_IDENTIFY, see setIdentify).
 */
class PodNetwork : public IPodNetwork {
    public:
        bool begin(uint32_t setId);

        // While enabled, unknown peripherals are claimed until maxPods are in the set
        void setAcceptNewPods(bool accept, uint8_t maxPods);

        // Processes received frames. Call once per loop pass.
        void service();

        // Game over (stop): RESET to every pod (off, activation cancelled), pending events dropped, no new
        // pods, no sync. The pods stay joined; run service() on so they keep their heartbeat.
        void endGame();

        // Keeps the first maxPods pods; the others are let go (no PONG, they search for a central again)
        void keepPods(uint8_t maxPods);

        // Program store sync in both directions; switch off while a game runs
        void setSyncAllowed(bool allowed);

        // The pods show their identity (number and colour, spinning) while this is on: menu, discovery, confirm
        void setIdentify(bool on) { this->identify = on; }

        bool allAlive() const;

        // --- firmware distribution to the peripherals (#130, #131, #132; link-protocol.md section 5.3) ---
        // The image is the verified one in Ota. AUTO sends it to all pods at once when two or more need it.
        enum class OtaMode : uint8_t { AUTO, UNICAST, BROADCAST };
        void otaStart(OtaMode mode);
        void otaStop();                                 // pods discard what they have (PONG_FLAG_OTA gone)
        bool otaActive() const { return this->ota.active; }
        uint8_t otaPercent() const;                     // the mean of the pods that need the image
        void otaDescribe(JsonArray out) const;          // status.ota.pods[]
        std::vector<uint8_t> otaNotReady() const;       // pods that run another version and do not hold the image
        uint8_t otaActivatePods();                      // OTA_ACTIVATE to every ready pod; how many
        bool otaFlushed() const { return this->link.idle(); }

        bool isStarted() const { return this->link.isStarted(); }
        bool isSyncing() const { return this->sync.isPulling(); }

        // Connection data of every pod: id, mac, alive, lastSeenMs, effects, link statistics, battery
        void describe(JsonArray out) const;

        // Cell voltage of a pod from its PING (mV); 0 = unknown (older firmware or no reading)
        uint16_t batteryMv(uint8_t podId) const { return podId < this->pods.size() ? this->pods[podId].batteryMv : 0; }

        uint8_t podCount() const override { return (uint8_t)this->pods.size(); }
        bool isAlive(uint8_t podId) const override;
        uint8_t arm(uint8_t podId, const ArmCommand& command) override;
        void reset(uint8_t podId) override;
        bool pollEvent(PodEvent& event) override;
        int64_t nowUs() const override { return esp_timer_get_time(); }
        bool supportsEffects(uint8_t podId) const override;
        bool supportsHold(uint8_t podId) const override;
        bool supportsToggle(uint8_t podId) const override;
        bool effect(uint8_t podId, const Protocol::EffectDesc& effect, int64_t startAtUs) override;

    private:
        static const int64_t POD_TIMEOUT_US = 1500000;
        static const int64_t CLAIM_TIMEOUT_US = 500000;

        struct Pod {
            uint8_t mac[6];
            int64_t lastSeenUs = 0;
            uint8_t cmdSeq = 0;
            uint8_t linkFeatures = 0;   // Protocol::LINK_FEATURE_*
            uint16_t batteryMv = 0;     // from PING (firmware >= 2.13), 0 = unknown
            uint8_t fwMajor = 0;        // from HELLO, 0 = not known
            uint8_t fwMinor = 0;
            uint8_t otaState = 0;       // from PING (firmware >= 2.20): Protocol::OTA_POD_*
            uint8_t otaPercent = 0;
            int64_t otaOfferedUs = 0;   // last OTA_OFFER to this pod
        };

        // One distribution. WAIT: pods may still join. PREPARE (broadcast): the pods erase their slot. STREAM: the
        // chunks go out as broadcasts. PULL: pods fetch what they miss, one at a time for the pods that have nothing.
        struct OtaRun {
            enum class Phase : uint8_t { WAIT, PREPARE, STREAM, PULL };
            bool active = false;
            OtaMode mode = OtaMode::AUTO;
            Phase phase = Phase::WAIT;
            int64_t phaseUs = 0;        // start of the phase
            int64_t lastJoinUs = 0;
            uint32_t cursor = 0;        // STREAM: next chunk
            int64_t nextChunkUs = 0;
        };

        int16_t findPod(const uint8_t* mac) const;
        void sendClaim(const uint8_t* mac, uint8_t podId);

        void otaService();
        void otaOffer(Pod& pod, bool broadcast);
        bool otaCurrent(const Pod& pod) const;          // runs the offered version already
        bool otaSupported(const Pod& pod) const;
        bool otaAlive(const Pod& pod) const;

        void handleHello(const RxFrame& frame);
        void handleClaimAck(const RxFrame& frame);
        void handlePing(const RxFrame& frame, int16_t podId);
        void handlePressed(const RxFrame& frame, int16_t podId);
        void handleReleased(const RxFrame& frame, int16_t podId);

        EspNowLink& link = EspNowLink::get();
        uint32_t setId = 0;
        std::vector<Pod> pods;
        std::deque<PodEvent> events;
        StoreSync sync{0};
        bool syncAllowed = true;
        bool identify = false;

        bool acceptNew = false;
        uint8_t maxPods = 0;

        OtaRun ota;

        bool claimPending = false;
        uint8_t claimMac[6];
        uint8_t claimFwMajor = 0;
        uint8_t claimFwMinor = 0;
        int64_t claimSentUs = 0;
};
