RunningJoke/reactionButton/src/Modes/ReactionMode/ReactionMode.h

#pragma once

#include <Arduino.h>
#include "../VMode.h"
#include "BluetoothManager/BluetoothManager.h"
#include "LEDManager/LEDManager.h"

class ReactionMode : public VMode 
{
    protected:
        uint8_t internalState = 0;
        uint64_t internalTimerStart = 0;
        uint64_t reactionTimerStart = 0;
        uint64_t reactionTimerStop = 0;
        uint64_t reactionTimerDelay = 0;
        LEDManager* ledManager;
        BluetoothManager* bleManager;

        void blink(ColorSet* color, uint8_t repetitions);
    public:
        ReactionMode(LEDManager* ledManager, BluetoothManager* bleManager);
        void run(uint64_t timestamp) override;
        void reset() override;
};
