RunningJoke/reactionButton/(commit log)

2024-02-25 started pcb design
    [PCB Board.kicad_pcb, PCB Board.kicad_sch]
2024-03-03 started work on the pcb and cad data
    [BOB-12009.step, PCB Board.kicad_pcb, PCB Board.kicad_sch, casing_v1.FCStd, casing_v2.FCStd]
2024-03-03 switched to neopixel library
2024-03-03 continued work on pcb
    [PCB Board.kicad_pcb]
2024-03-23 updated pcbs
    [PCB Board.kicad_pcb, PCB Board.kicad_sch]
2024-03-23 switched button pin and from NO to NC buttons
2024-04-06 [SQUASH]childParentPodSystem
    commit 17b5b5690929541e9e3c602d57639d9a022262b0
    Author: Patrick Schwederski <schwederski@alli-go.de>
    Date: Sat Apr 6 08:08:58 2024 +0200
    added deactivation support
    commit b45540698f9067959a224b0df5a33577f7efcb2b
    Author: Patrick Schwederski <schwederski@alli-go.de>
    Date: Sat Apr 6 07:41:10 2024 +0200
    fixed a crash at the end
    commit 491c63b8481cf541a059b4fd26308035c36f6f7b
    Author: Patrick Schwederski <schwederski@alli-go.de>
    Date: Mon Apr 1 22:25:02 2024 +0200
    [WIP] save progress
    currently not sending the data to the child nodes in alternating mode correctly. might be that the connection needs to be reestablished every time?
    commit 6600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
    [partitions.csv]
2024-04-06 [SQUASH]cad-updates
    commit c678f14861f166de3e1cfd3d47229260420130a8
    Date: Sat Mar 30 11:50:47 2024 +0100
    updated gitignore
    commit 5fc02eb109b8c870fff1fefb557780ef132b5a4d
    Date: Sat Mar 30 11:50:29 2024 +0100
    updated cad files
    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
    [casing_v2-Aussenhülle.stl]
2024-04-06 added stl files
    [casing_v2-BuzzerknopfLED_zentral.stl, casing_v2-Innendeckel.stl, casing_v2-LED-Mount.stl, casing_v3-Aussenhülle.stl, casing_v3-Innendeckel.stl, casing_v3-antirutschschablone.stl]
2025-03-07 updated pcb design schematic
    layouting missing. Also add on/off switch for battery (best solution with circumventing switch on charge
    [PCB Board.kicad_sch, led_array.kicad_sch]
2025-03-16 [WIP] save changes
    [20250308_octopart_sourced_bom.csv, JLCPCBBOM.csv, PCB Board.csv, PCB Board.kicad_pcb, PCB Board.kicad_sch, led_array.kicad_sch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]
2025-03-16 updated schematic
    [JLCPCBBOM.csv, PCB Board.kicad_sch, jlcpcbUpload.xlsx]
2025-03-21 commit schematic as pdf
2025-03-22 updated with charging circuit
    [PCB Board.kicad_pcb, PCB Board.kicad_sch]
2025-03-26 updated pcb design
    [JLCPCBBOM.csv, JLCPCBBOM.xlsx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]
2025-03-26 commit cad design
    [slimCasing.FCStd]
2025-03-29 finished casing design
    [slimCasing.FCStd]
2025-04-03 fixed a wrong switch footprint
    [PCB Board.kicad_pcb, PCB Board.kicad_sch]
2025-04-03 commit first set of cad files
    [slimCasing-Aussenhaut.stl, slimCasing-Buzzerkopf.3mf, slimCasing-Buzzerkopf.stl, slimCasing-Case.3mf, slimCasing-Innendeckel.stl, slimCasing.FCStd]
2025-04-06 [WIP] updated casing files
    [slimCasing-Buzzerkopf.stl, slimCasing.FCStd]
2025-05-23 new buzzer layout
    [slimCasing_new.FCStd]
2025-05-23 updated cad data
    [slimCasing_new.FCStd]
2025-05-23 commit new 3d data files
    [slimCasing-Buzzerkopf.3mf, slimCasing_new-Aussenhuelle.stl, slimCasing_new-Buzzerkopf.stl, slimCasing_new-Unterteil.stl, slimCasing_new.FCStd]
2025-05-24 save new files
    [slimCasing_new-Buzzerhead.3mf, slimCasing_new-Case.3mf]
2025-05-24 adjusted tolerances
    [slimCasing_new-Aussenhuelle.stl, slimCasing_new-Buzzerhead.3mf, slimCasing_new-Buzzerkopf.stl, slimCasing_new-Unterteil.stl, slimCasing_new.FCStd]
2025-05-25 another iteration of design
    [slimCasing_new-Aussenhuelle.stl, slimCasing_new-Case.3mf, slimCasing_new-Unterteil.stl, slimCasing_new.FCStd]
2025-05-25 added new board config
2025-05-25 [WIP]add press button block
2025-05-30 improved button block to handle more functionality
2025-05-30 reworked for reaction buzzer functionality
    [main.cpp]
2025-05-30 updated layout of case again
    [slimCasing_new.FCStd]
2025-09-14 store current progress
2025-09-15 updated casing
    [casing_v3-Aussenl.stl, casing_v3-Innendeckel.stl, slimCasing-Aussenhaut.stl, slimCasing-Buzzerkopf.stl, slimCasing-Innendeckel.stl, slimCasing_new-Aussenhuelle.stl, slimCasing_new-Buzzerkopf.3mf, slimCasing_new-Buzzerkopf.stl]
2025-09-21 cleaned up 3d casing data
    [PCB Board.stl, casing_v1.FCStd, casing_v2-Aussenhülle.stl, casing_v2-BuzzerknopfLED_zentral.stl, casing_v2-Innendeckel.stl, casing_v2-LED-Mount.stl, casing_v2.FCStd, casing_v3-Aussenhülle.stl]
2025-09-29 added first draft of charging dock
    [slimCasing_new-Ladestation.stl, slimCasing_new.FCStd]
2025-09-29 switched framework for support of up to 7 buzzers. And large rework
    [_Definitions.h]
2026-10-18 Load game programs from JSON instead of hard-coded block configs
    Block system:
    - Block base class with configure(json)/enter/execute/exit and named
    output ports; links are resolved to indices at load time
    - BlockManager loads programs from SPIFFS, supports "include" fragments,
    validates types, parameters and links, chains instant blocks per pass
    - Values can be constants or variable references; variables are
    resolved to ids at load time
    - Non-blocking delay, button block on press edge with debounced
    Input/Button (held buttons no longer leak into the next step),
    timeouts for button/remote blocks
    - New summary block and Results (RESULT/SUMMARY CSV on serial); reaction
    times from pe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
2026-10-18 Replace the BLE pod link with ESP-NOW
    Peripherals no longer use BLE; pods talk over ESP-NOW frames (src/Link):
    - Protocol: HELLO/CLAIM/CLAIM_ACK, PING/PONG heartbeat with NTP-style
    clock sync, ARM (immediate or scheduled start), RESET, PRESSED with
    command sequence numbers and reaction time in microseconds
    - EspNowLink: ordered, acknowledged unicast per peer with retries,
    urgent frames, duplicate filtering, transmit timestamps
    - Roles: CentralRole (menu, discovery, confirm, run, pause/resume),
    PeripheralRole (claim, clock sync, arm/measure/report), RoleManager
    - Pairing via a shared set id in NVS; pods of other sets are ignored
    - Lost pods pause the game; it resumes and re-arms the p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
2026-10-18 Add program store sync between pods and BLE config API
    - ProgramStore: manages /programs.json and /prog/*, CRC per file,
    manifest hash, atomic commit via temp files, store generation in NVS
    (a local change always gets a generation above all seen ones; files
    replaced by uploadfs count as a local change)
    - StoreSync: PING/PONG carry generation + hash; the pod with the older
    store pulls manifest and changed files with SYNC_READ requests and
    switches them at once. Runs in both directions, never during a game
    - BLE config API on the central in the menu: info, list, get, put
    (chunked, CRC and JSON check), delete, validate as JSON lines over a
    command/response characteristic pair; men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
2026-10-18 Add USB serial console, test commands and diagnostics
    - Fix: drop ARDUINO_USB_CDC_ON_BOOT/ARDUINO_USB_MODE from
    platformio.ini. With "arduino, espidf" they only reached src/, so
    Serial meant a UART object in the core and a USB object in our code.
    All output now goes to a dedicated HWCDC console (USB) including
    ESP-IDF log lines
    - ConfigApi: transport-independent request handling shared by BLE and
    the new USB serial console (JSON or text commands, event lines)
    - New ops: status (state, program, pods, link statistics, variables),
    programs, select, start, press (simulated button), stop, results,
    trace (block enter events), reboot with a one-shot boot role, help
    - Central reports s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
2026-10-18 Add config app scaffold and specification
    Web app (PWA, later Capacitor) to read, edit, simulate and push ReactPod
    programs over BLE and USB serial. This commit holds the agreed spec,
    acceptance tests and phase P0: Vite + React + TypeScript, PWA manifest and
    service worker, i18n (English primary, German), theme tokens and the
    mobile-first app shell with placeholder screens.
2026-10-18 Add change requests from the config app
    Ranked firmware / config API changes the config app would benefit from
    (BLE set names, program format revision, engine semantics docs, inline
    validate, list metadata, optional PIN). The app works without them.
2026-10-18 Add BLE and USB serial transports and the Pod screen (P2)
    - WebSerialTransport: Espressif VID filter, 115200 baud, never touches
    DTR/RTS, writes in 1 KB pieces for the firmware's 4 KB RX buffer
    - BleTransport on @capacitor-community/bluetooth-le: Web Bluetooth now,
    native later; MTU-sized writes with response, line reassembly
    - pod session store: connect, info/status/list, read-only on
    peripherals, firmware check, log for the debug console
    - Pod screen with Bluetooth / USB / demo pod, pod facts and file groups;
    debug console in Settings
    - tests with fake Web Serial and BLE; scripts for screenshots and the
    offline check (playwright-core with the local Chrome)
    BLE responses need fir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
2026-10-18 Add programs list and read-only block graph view (P3)
    - graph model: nodes, edges, start, end, unreachable, external targets,
    firmware fallback to next
    - dagre layout (top to bottom) and React Flow view with block nodes,
    routed edges with port labels, opens at the top at a readable zoom
    - programs screen: programs on the pod (read after connecting, cached
    in IndexedDB by size + CRC), shipped programs, library; menu pattern,
    pods, blocks and validation status per program
    - program view with details, issues and a block sheet; LED ring component
    - view page loaded on demand; acceptance tests AT-U5 (LED ring
    orientation) and AT-U6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
2026-10-18 Add connection dialog and single-column block view
    The header chip opens a dialog to connect (Bluetooth, USB, demo pod)
    or disconnect; the Pod tab shows a Connect button when no pod is
    connected. The block graph is now one column of cards in flow order:
    blocks that just continue to the block below have no arrow, choices and
    jumps are side arrows (down right, loops left) sharing lanes per target.
    React Flow and dagre are removed.
2026-10-19 CR-3: document the engine semantics in programs.md
    New section 7 describes the step limit per loop pass, instant vs waiting
    blocks, random ranges, button press/release/timeout rules, remotePress and
    remoteMultiPress edge cases and summary without values, with code references,
    so the Config App simulator can match the pod. Docs only.
    Claude-Session: https://claude.ai/code/session_01J9pA6or1vRqQqFCiitQRPL
2026-10-19 CR-6: optional PIN for write operations over BLE
    A PIN (4-6 digits, NVS) set over USB serial with setPin makes put, delete and
    setName over BLE return auth_required until the client sends auth with the
    PIN on the same connection. A wrong PIN blocks auth for 3 s. info reports
    pinRequired. USB serial never needs the PIN, so the owner can always clear
    it. Firmware 2.6.
    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
2026-10-19 configApp: use firmware 2.7 features (set name, PIN, list metadata, inline validate)
    Protocol types, PodClient ops auth / setName / validate with data, demo pod like firmware 2.7,
    rename set on the Pod tab with PIN prompt, program names from list metadata.
2026-10-19 configApp P5: sync, push, restore defaults, delete files, set zip
    - pod/sync.ts: state per file (in sync / changed here / changed on the pod / conflict / new)
    from the last common CRC per set, push and restore plans with missing presets and the menu
    last, push with the pod's dry run (validateInline) before anything is written, then validate
    - Pod tab: changes with take over / keep pod / keep mine, push dialog (selection, local errors
    linked to the block, PIN, progress, pod errors), restore defaults
    - Settings > Advanced: delete files with a hold-to-delete confirmation
    - Programs tab: export / import a whole set as .zip (fflate)
    - sync state saved per set in IndexedDB; editor opens a bl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
2026-10-19 configApp P6: simulator
    - simulator/engine.ts: the block engine ported from the firmware (programs.md §7): one pass
    per simulated ms, 32 steps per pass, button / remote / multi-press / summary semantics,
    peripherals like PeripheralRole, seeded random numbers
    - Simulate tab: all pods as LED rings with a press-and-hold button, graph with the current
    block, the arrow just taken and breakpoints, run / pause / step / skip wait / reset,
    speed x0.25-x4, seed, variables, measurements, log with a trace export
    - play button in the editor and the program view; placeholder page removed
2026-10-19 Restructure the repo: firmware/, app/, docs/, hardware/; CI and issue forms (#13)
    ## What and why
    Repo rework step 1+2 (layout, CI, templates). Prepares for OTA (firmware
    binaries published next to the app on Pages) and the community platform
    (`platform/` later).
    - `firmware/` (src, data, platformio.ini, …) — build from the root with
    `pio run -d firmware -e NewBoard`
    - `configApp/` → `app/`, `cad/` → `hardware/`, `doc/` →
    `docs/{firmware,app,user,archive}`
    - boilerplate removed (`include/`, `lib/`, `test/`,
    `sdkconfig.NewBoard.old`, `customPartitions.csv`)
    - all paths fixed (app bundles `../firmware/data`, tools, doc links via
    git rename map, comments)
    - workflows: `app.yml` (PR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
2026-10-19 Squashed commit of the following:
    commit 6e17dbfb27ec9b36124c3d76a34ecbfec2d3e38d
    Author: Patrick Stähle <pstaehle@alli-go.de>
    Date: Mon Oct 19 13:18:12 2026 +0200
    Docs: flash budget = firmware.bin vs. app slot
    Co-Authored-By: Claude Opus 5.5 <noreply@anthropic.com>
    commit 7b2c8a441d2822c4f8f1cfdc0d7e1ef7a4a98948
    Author: Patrick Stähle <pstaehle@alli-go.de>
    Date: Mon Oct 19 13:17:29 2026 +0200
    docs/archive: point to the issues and milestones
    Co-Authored-By: Claude Opus 5.5 <noreply@anthropic.com>
    commit d4099016f2d68b4cb66b31135b56263588c13417
    Author: Patrick Stähle <pstaehle@alli-go.de>
    Date: Mon Oct 19 13:14:55 2026 +0200
    Short CLAUDE.md, README, CONTRIB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
2026-10-20 Firmware: timerStart / timerStop flags and repeat block (programFormat 2) (#62)
    Program format revision 2, firmware 2.8:
    - **#40**: any block may have `timerStart` and `timerStop`. A timer
    starts when the block is entered. When a block with `timerStop` is left,
    the time since the start is recorded as metric `<name>` for the central,
    the same way `record` stores a value.
    - At most 16 timer names per program.
    - A pause doesn't stop or restart a timer, so the paused time is
    included.
    - `status.timers.orphanStops` counts stops for a timer that was not
    running.
    - **#54**: new `repeat` block with `count` and an optional `storeIndex`,
    and ports `next` / `body` / `done`.
    - It coun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
2026-10-20 Firmware: ring effect player and EFFECT frames on the link (#63)
    #53, the foundation of epic #52:
    - **Effect player in `LEDManager`**:
    - 10 effects: solid, fill, drain, dim, colorShift, trafficLight, blink,
    pulse, spin, level.
    - Each frame is computed from the shared synced start time, so all pods
    show the same frame.
    - At most one frame every 16 ms.
    - A brightness cap applies to all output.
    - When nothing animates, the player costs nothing, so light sleep (#21)
    still works.
    - **Link changes**:
    - New `EFFECT` frame (type 11).
    - `ARM` can carry an optional waiting effect.
    - `CLAIM_ACK` gains a `linkFeatures` byte.
    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
2026-10-20 Hardware test #38: BleEspNowTest build, test script, checklist, ADR 0005 (proposed) (#64)
    Prepares the hardware test #38: does BLE stay connected while ESP-NOW
    runs? The test itself still has to be run on real pods; this PR does not
    close #38.
    - **Firmware**:
    - A separate env `[env:BleEspNowTest]` (`-DREACTPOD_BLE_ESPNOW_TEST`).
    It keeps BLE on during the game, asks for a 75 ms connection interval,
    adds a `bleTest` op and extra `status` fields, and makes peripherals
    count late ARMs and LED-on delay.
    - All hooks are guarded by the flag. The only unguarded change moves
    `PhoneConfig::sendLine`'s send loop into `indicateLine()`; behaviour is
    unchanged.
    - **`tools/ble_espnow_test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
2026-10-26 Platform, block builder, effect/countdown/charge/release (firmware 2.9, format 3) (#67)
    Platform PL0–PL3, block builder P8, and Sprints 1 and 2 of epic #52.
    - **Platform** (`platform/`): Hono + Postgres modular monolith, use
    cases exposed as REST and MCP, OpenAPI in `spec/`
    - **Shared package** `packages/program-model`: types, block definitions,
    limits and validator, used by both the app and the platform
    - **Firmware 2.9, program format 3:** `effect` block, `countdown` option
    on timed blocks, `charge` and `release` blocks, link revision 2 (`hold`
    feature, RELEASED frame)
    - **App:** the new blocks in the model, editor, simulator and demo pod,
    plus the P8 block builder
    - **Docs:** ADR 0006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
2026-10-28 Sprint 3: toggle block, firmware cleanup and fixes (firmware 2.10, format 4) (#70)
    Sprint 3: firmware 2.10 (program format 4, link revision 3) and the end
    of epic #52.
    - **#59 `toggle` block:** pods flip between two team colours on every
    press (domination). New `PodMode::TOGGLE`; PRESSED carries the owner and
    the flip count; link revision 3; programFormat 4.
    - **#60 / #61:** toggle in the program model, simulator, demo pod and
    editor (the "Domination" step, en + de). A shared validator case file
    (`tools/validator_cases.json`) keeps the Python and the app validator in
    agreement.
    - **#9:** a new BLE client no longer receives the leftover bytes of the
    previous one.
    - **#22:** the program menu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
2026-10-29 Firmware: USB serial responses no longer stall (#74) (#77)
    Closes #74
    **Cause:** not lost but late. Every "lost" response arrived exactly when
    the host sent the next request: the ESP32-C3's HWCDC (arduino-esp32)
    left the end of a line in its TX ring buffer / FIFO until the next
    `write()` kicked it. The raw byte stream had all responses, so the
    earlier test with requests every 0.3 s only looked like loss because of
    the 2 s client timeout.
    **Fix:** `consoleKick()` in the serial service loop: at most every 10
    ms, while bytes are queued, flush the USB-Serial-JTAG FIFO and re-enable
    the IN_EMPTY interrupt (what `HWCDC::write` does).
    **Hardware (COM4, peripheral):**
    - before: 12/50 responses la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
2026-10-29 Release hardware checklist and measured timing values (#23, #24) (#78)
    Closes #23
    Refs #24 (part 1 done; the logic-analyser start spread is left)
    - **#23:** `docs/firmware/testing.md` §12: 11-line release checklist
    (serial, every program, full set, pause / pod loss, power cycle,
    reports, 30 min soak, two sets, battery run-down, start spread, app).
    The `/release` skill points to it.
    - New `tools/reactpod_hwtest.py`: runs the automated lines (1, 2, 4, 5,
    6) over USB with a central and 1+ peripherals, restores the pods' roles,
    exit 1 on failure.
    - **#24 part 1:** `timing.md` uses the ADR 0005 measurements (0 of 60
    000 frames lost, ack round trip 1.6–1.8 ms avg / 10.7 ms max, clock
    jitter 0.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
2026-10-29 Sprint 7: battery, pod identity, summary on the ring (firmware 2.13) (#79)
    Sprint 7 (milestone "Reliable sessions"). Firmware 2.13, link revision
    4, program format 6.
    Closes #19
    Closes #20
    Closes #25
    ## Changes
    - **#19 Battery:** cell voltage on GPIO 5 (divider 100 k / 100 k from
    the schematic), 32 samples, smoothed; percent curve 3.3–4.2 V.
    `status.battery`, per pod in `status.pods[].battery` (appended to PING),
    feature `battery`. Boot spinner replaced by a battery gauge (the
    button-hold-to-central behaviour unchanged). Amber blink on an idle low
    pod (< 15 %), `start` refused with `low_battery` below 5 %. App shows
    the levels.
    - **Found on hardware:** GPIO 5 is ADC2, and ESP-IDF 4.4 ref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
2026-10-29 Sprint 8: power management, auto power-off (firmware 2.14) (#80)
    Sprint 8 (milestone "Reliable sessions"). Firmware 2.14.
    Closes #21
    - **Idle loop:** in idle states (peripheral UNCLAIMED / READY, central
    MENU / CONFIRM / ERROR) the loop waits up to 1 ms for a radio frame
    instead of spinning; armed activations and RUN keep the fast loop
    (timing.md §1).
    - **LEDs:** every write goes through one `present()` that calls `show()`
    only on a changed frame; `LED_BRIGHTNESS_CAP` in one place, **left at
    255 (no visible change)**. The agent proposed 160 (about 37 % dimmer);
    that is a decision for you.
    - **Auto power-off:** an unclaimed pod, or a central in the menu without
    a phone, drains t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
2026-10-29 Athlete deletion: self-delete everywhere, deletions on sign-in (#48) (#83)
    Closes #48
    Implements the two decisions from the issue:
    1. **Queued platform deletions run on sign-in** (and at app start or
    when coming back online while signed in), whether auto upload is on or
    off.
    2. **Deleting an athlete removes everything:**
    - The athlete who claimed the profile deletes it with the new use case
    `delete_my_athlete_profile` (`DELETE
    /v1/orgs/{orgId}/me/athletes/{athleteId}`, agent deny, audit ids only).
    The owner check is the claim; anyone else gets 404.
    - Self-delete and the coach's `deleteAthlete` share one helper. It
    deletes the athlete's training sessions (reports and values cascade) and
    inv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
2026-10-29 One set at a time; platform development on hold (ADR 0007) (#84)
    Refs #46, #37
    - **Several sets at once removed from the app.** The phone test of #46
    showed only one set and no way to switch. `connectPod` now ends any
    existing session before connecting; the *Add another set* buttons
    (connect dialog, training view), the *Active* badge and *Show in Pod
    tab* are gone. BLE reconnect with reports fetch + ack and the training
    view for one set stay. The session list stays as the structure for
    later. Tests updated (575 pass); the multi-set acceptance tests (AT-L1,
    L2, L8) are marked on hold.
    - **Platform on hold:** new [ADR
    0007](docs/decisions/0007-platform-on-hold.md). Platform development is
    hal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
2026-10-30 Compact the docs; full texts moved to the wiki (#85)
    The docs had grown to 459 KB in 37 Markdown files. This makes the
    instructions for agents short and precise without dropping information:
    165 KB in 19 files (−64 %).
    - **Wiki:** full text of every Markdown doc as of 707b4a0 at
    https://github.com/RunningJoke/reactionButton/wiki (user and coach
    guides live there from now on).
    - **Removed** (wiki + git history only): `CONTRIBUTING.md` (merged into
    `CLAUDE.md`), `docs/archive/`, `docs/user/*.md`,
    `docs/firmware/README.md` (quick facts → architecture §1), the single
    ADR files (now one paragraph each in `docs/decisions/README.md`, numbers
    kept).
    - **Compacted:** `CLAUDE.md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
2026-10-30 Firmware 2.15: light language (boot, set-up, menu, pause, sleep patterns) (#93)
    The new light language from the Light lab (#82), accepted on real pods.
    All non-game signals are firmware-only **system patterns**
    (`LEDManager/SystemPattern`), played on the effect player; no program
    format change.
    - **Boot:** blue-cyan battery gauge (amber below 20 %, darker than the
    timer), then a 1.6 s white timer; button held at the end → central.
    - **Peripheral:** bouncing amber search while unclaimed; after a claim
    pod n flashes n LEDs in its colour, then stays dim with green breathing;
    low battery = LED 9 amber alone.
    - **Central:** menu pattern breathes while a phone is connected; hol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
2026-10-30 Firmware 2.16: NimBLE host instead of Bluedroid (#95)
    Closes #94
    The phone link now uses NimBLE-Arduino 1.4.3 (own host stack) on the IDF
    controller instead of Bluedroid, for RAM and flash (ADR 0008).
    `sdkconfig.NewBoard` is `BT_CONTROLLER_ONLY`; host limits are build
    flags in `platformio.ini` (one connection, MTU 517, peripheral role
    only).
    Wire format unchanged (UUIDs, indicate-only response, advertisement,
    MTU), so app and tools need no change.
    Differences in `PhoneConfig`:
    - NimBLE `indicate()` does not wait and drops a second indication while
    one is outstanding. The sender task now waits for `onStatus` (3 s
    timeout, then the line is dropped).
    - The server gets no con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
2026-10-30 App: start card, queued commands, priority lane (#87) (#101)
    Closes #87
    App part of #87 (training rework). Firmware part is #96 (`startVars`, fw
    2.17); the app works with older firmware.
    - **Start card in CONFIRM:** steppers from `status.ready.editable`,
    range checked before sending; *Start* sends `setVariables` only if a
    value changed, then `start`. No `startVars` → no steppers, only `start`.
    No `remote` → "Press the central to start."
    - **Queued commands:** Continue / Repeat / Stop pressed while nothing
    waits are kept (one pending, a newer press replaces it, *Cancel*) and
    sent when `status.waiting` appears. Pause / Resume are sent at once.
    - **Priority lane (`pod/cli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
2026-10-31 App: behaviours (Sprinkles) registry and field reclassification (#88, 1/3) (#100)
    Refs #88
    Part 1 of 3 (model): the step editor's "Sprinkles" (code id `behaviour`)
    as a registry, and the field reclassification of #88 §5. No firmware,
    program format, validator semantics, schema or demo pod change.
    - `app/src/editor/behaviours.ts`: registry with `id`, `appliesTo(block,
    mode, format)`, `isOn` (`on` / `off` / `custom`), `turnOn`, `turnOff`,
    `summary`, plus a group (Rules / Measure / Flow). 14 entries: Time limit
    (also on `communicate`), Red pods, Long press, Catch early presses, Hold
    first, Drains over time, Central takes part, Record reaction, Keep
    result, Report-to-phone se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
2026-11-03 App: design review rework – Train · Games · Results, game page, This set, results progress (#106) (#110)
    Design review rework of the Config App (phone first), umbrella #106.
    Approved concepts A–G on the design canvas.
    - **Navigation by task:** Train · Games · Results; the connection chip
    opens *This set*; old links redirect (`/pod`, `/programs*`, `/editor`,
    `/simulate`, `/training`, `/menu`).
    - **Train:** one live surface – state header in the pod-light colours,
    athlete chips, last round in big figures, steppers applied with
    Continue, Continue / Repeat / Pause / Stop in thumb reach, numbered
    connect guide.
    - **Games:** rows with description and pods needed, chips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
2026-11-03 App: countdown toggle and Keep-result switches in a sprinkle are plain rows (#104) (#111)
    `SwitchRow` gets a `flat` variant (hairline row, no card). The Time
    limit countdown toggle and the Keep-result switches of a toggle step use
    it, so there is no box inside a box (#88 §2).
    Closes #104
    ## Checks
    - [x] App: `npm test`, `npx tsc` (in `app/`); checked in a browser at
    360 and 1200 px, both themes
    - [x] UI texts unchanged
    ---------
    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
2026-11-03 App: Game settings panel, Quick game, design review polish and docs, screenshots fix (#106, #114) (#115)
    Follow-up to the design review rework (#106, PR #110), plus the
    screenshot script fix.
    - **One Game settings panel:** opened from About → *Change settings* (my
    games) or ··· → *Game settings*, in Edit mode with undo/redo. Name,
    description, pods, menu pattern, the settings people change most, and a
    "For the whole game" section (time limit, record times, results). It
    replaces the Adjust sheet. Shipped and pod games stay read-only and use
    *Make my copy*.
    - **Quick game** (`/games/new/quick`): game, pods, rounds, colour and
    name on one screen. It is the recommended c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
2026-11-04 App: desktop layouts – Edit with live simulator, Train, Results, This set, menu side by side (#107) (#117)
    Desktop layouts (≥ 900 px) after the design review. The phone layout is
    - **Shared layout:** `components/Split` gives two columns from 900 px:
    what you act on goes left, what you look at goes right and stays in view
    while you scroll. It comes with `useDesktop()` / `isDesktop()` and a
    `.wide` page class. Content that exists only on desktop is mounted only
    there; it is never hidden with CSS.
    - **Games → Edit:** step list on the left and the live simulator (the
    existing Try view) on the right. It restarts once, 400 ms after the last
    change. Try stays full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
2026-11-06 ADR 0009: OTA with two app slots, supersedes ADR 0006 (#136)
    Accepts OTA: two 1 792 KB app slots, 384 KB storage, rollback, signed
    images, phone → central → peripherals. ADR 0006 is marked superseded.
    Tracking: #119.
    Docs only.
    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
2026-11-06 Firmware: two OTA app slots, rollback bootloader, store budget warning (#120, #121) (#138)
    Sprint 1 of firmware OTA (ADR 0009): the flash layout that OTA needs,
    and the app warning that goes with the smaller program store.
    - **Layout (#120):** two 1.75 MB app slots, 384 KB store, rollback
    bootloader. Anti-rollback stays off. The firmware workflow warns above
    85 % of a slot and fails above 95 %.
    - **Store warning (#121):** the app warns when a set's programs exceed
    the store budget (144 KB, because a sync needs the store twice).
    No OTA code yet. Flashing this erases the programs on a pod, so run
    `uploadfs` afterwards.
    Stacked on #136; retarget to `main` after that is merge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
2026-11-07 Firmware: calmer update light without flicker, ota waits for the self-test (#125) (#140)
    The ring flickered during a firmware upload. The user asked for less: a
    dim white bar and red pulsing for what is still pending.
    - **Flicker:** the likely cause is LED frames sent while USB bytes
    arrive, which delays the RMT refill and corrupts the frame. This is
    inferred, not measured. Frames are now drawn between a request and its
    response. If no chunk arrives for 500 ms, the ring goes on by itself.
    - **Look:** bar at 40 %, and no white verify blip in `otaEnd` (about 150
    ms).
    - **Tools:** `ota` read `lastResult` right after boot, when it is still
    `none`, because #124 only settles it a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
2026-11-07 Firmware 2.20 + app: update the whole set over ESP-NOW, activate together, broadcast (#130–#133) (#142)
    Sprint 4 of firmware OTA (ADR 0009): the main pod passes a new firmware
    on to the other pods over ESP-NOW, and all pods switch together, the
    main pod last. The app shows one row per pod.
    - **Firmware 2.20, link revision 6:**
    - #130: `otaDistribute`, the `@ota` pull and the peripheral UPDATE state
    with a chunk bitmap; `status.ota.pods[]` and `status.pods[].firmware`.
    - #131: `otaActivate` for the set, with `not_ready` and `force`. `force`
    is allowed only when the link versions are the same.
    - #132: broadcast at 1M, 4 ms pace, then a pull repair. In `auto` mode
    the main p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
